PFOC2203/Sistema-de-Controlo-de-Temperatura-utilizando-Celula-de-Peltier/Hardware/PCB.jpeg

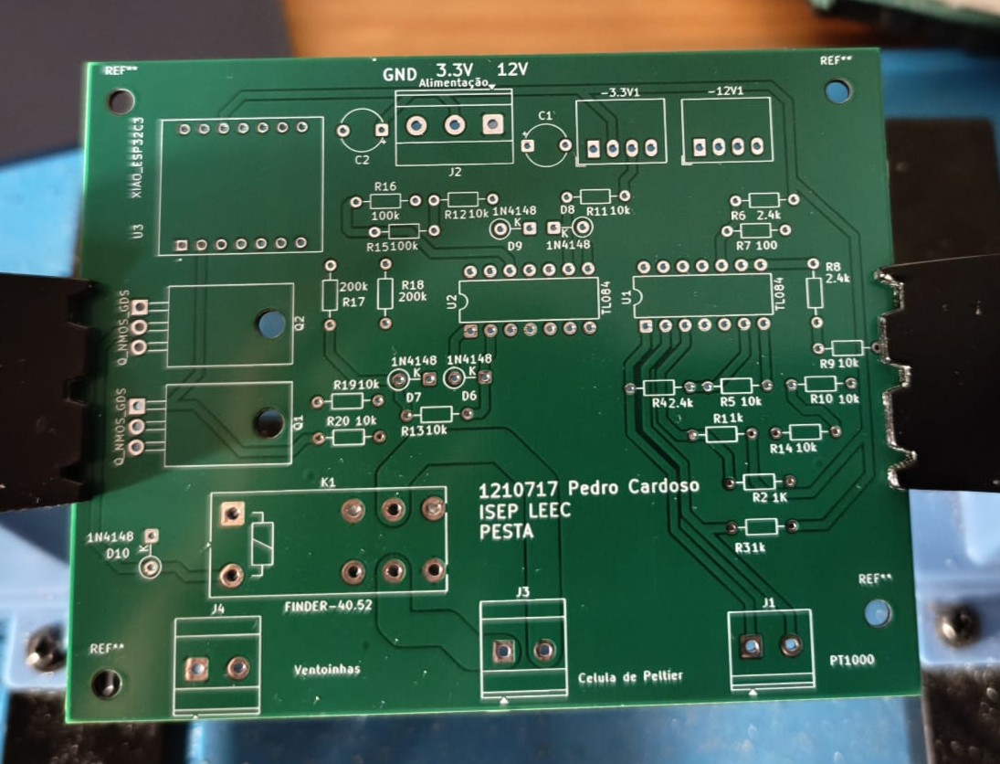
Hardware/PCB.jpeg
