PFOC2203/Sistema-de-Controlo-de-Temperatura-utilizando-Celula-de-Peltier/Hardware/Camera de temperatura regulavel .jpeg

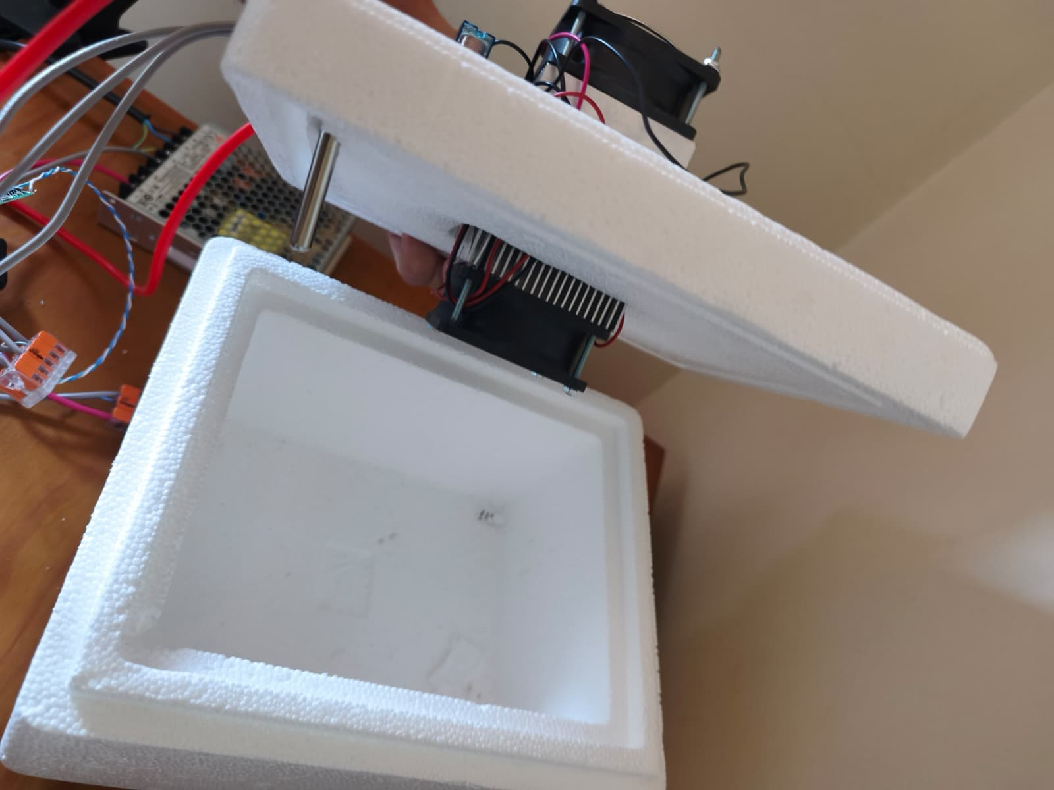
Hardware/Camera de temperatura regulavel .jpeg
