PFOC2203/Sistema-de-Controlo-de-Temperatura-utilizando-Celula-de-Peltier/README.md

# Sistema-de-Controlo-de-Temperatura-utilizando-C-lula-de-Peltier
"Sistema IoT de controlo de temperatura com ESP32C3, Célula de Peltier e interface Web.
