PFOC2203/Sistema-de-Controlo-de-Temperatura-utilizando-Celula-de-Peltier/Relatorio/PESTA_LEEC_RELATORIO v1_1.docx

Sistema de Controlo de Temperatura utilizando Célula de Peltier

Pedro Filipe Oliveira Cardoso

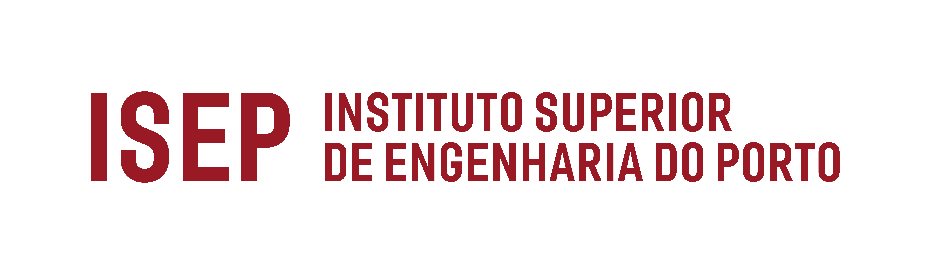
[picture p3: figure]

Departamento de Engenharia Eletrotécnica

Instituto Superior de Engenharia do Porto

2026

Este relatório satisfaz, parcialmente, os requisitos que constam da Ficha de Unidade Curricular de Projeto/Estágio, do 3º ano, da Licenciatura em Engenharia Eletrotécnica e de Computadores

Candidato: Pedro Filipe Oliveira Cardoso, Nº 1210717, 1210717@isep.ipp.pt

Orientador: Ricardo Jorge Guedes da Silva Nunes da Costa, RJC@isep.ipp.pt

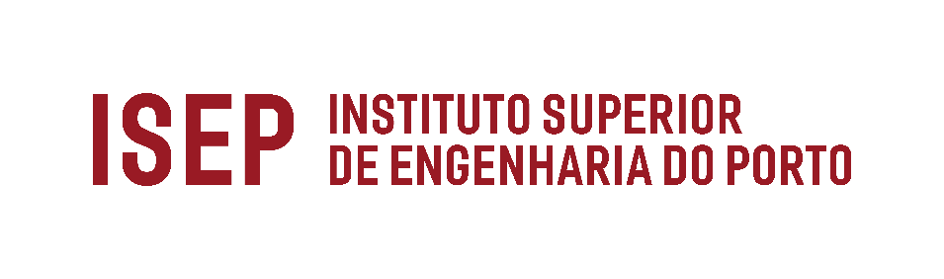
[picture p4: figure]

Departamento de Engenharia Eletrotécnica

Instituto Superior de Engenharia do Porto

10 de julho de 2026

# Agradecimentos

O desenvolvimento deste projeto e a conclusão desta licenciatura representam o culminar de uma jornada de enorme exigência. A realidade de ser trabalhador-estudante impôs o desafio diário de conciliar as responsabilidades profissionais com o rigor académico da Engenharia Eletrotécnica e de Computadores, um percurso de sacrifício e resiliência que não teria sido possível sem uma forte rede de apoio.

Em primeiro lugar, gostaria de expressar o meu mais profundo agradecimento aos meus pais e ao meu irmão. Foram o meu maior pilar, compreendendo as minhas ausências e incentivando-me constantemente a não desistir desta dupla jornada, levando-me sempre a elevar o nível deste projeto.

Ao meu orientador, o Eng.º Ricardo Costa, agradeço todo o apoio técnico, a disponibilidade e os valiosos conselhos prestados durante a realização deste trabalho.

Gostaria também de deixar um agradecimento especial ao meu tio, o Eng.º Jorge Cardoso, por toda a ajuda na discussão e descoberta de novas abordagens e soluções, que foram fundamentais para o desenvolvimento tecnológico do protótipo.

Por fim, agradeço a todos os que, direta ou indiretamente, contribuíram para a concretização deste relatório e para o meu crescimento pessoal, académico e profissional.

# Resumo

O presente trabalho descreve o desenvolvimento de um protótipo funcional de uma marmita térmica inteligente com conectividade IoT, concebida para responder de forma inovadora à problemática da conservação e regeneração alimentar controlada remotamente. O sistema proposto baseia-se numa arquitetura embebida centrada no microcontrolador XIAO ESP32-S3, responsável por gerir a monitorização térmica em tempo real através de um sensor RTD PT1000 de elevada precisão e por atuar sobre o controlo de potência de uma célula de Peltier. No domínio do hardware, concebeu-se e implementou-se uma placa de circuito impresso (PCB) biface otimizada para baixo ruído, integrando uma Ponte de Wheatstone e um circuito delimitador de precisão (Precision Bounding Circuit) com amplificadores operacionais TL084, garantindo o confinamento seguro do sinal analógico na gama analógica de 0 V a 3,3 V. O firmware foi estruturado sob o sistema operativo em tempo real FreeRTOS, recorrendo a mecanismos de exclusão mútua (Mutex) para assegurar a concorrência segura entre as tarefas críticas de aquisição de sinal e a gestão do servidor Web assíncrono embebido. Os ensaios experimentais e a validação laboratorial comprovaram o elevado desempenho dinâmico da malha de controlo digital por histerese, registando uma elevação transiente desde os 35,3 °C até um pico de regeneração de 95,5 °C em aproximadamente 21 minutos, bem como uma estabilização controlada na vizinhança dos 18 °C na fase de arrefecimento. Por fim, a análise económica validou a viabilidade do protótipo com um custo total de investimento de 124,16 €, projetando uma elevada competitividade de mercado num cenário de transição para a produção industrial em série.

Palavras-Chave: Célula de Peltier, IoT, ESP32-S3, PT1000, FreeRTOS, Condicionamento de Sinal.

# Abstract

This work describes the development of a fully functional prototype for an IoT-enabled smart thermal lunchbox, designed to address the engineering challenges of remote food preservation and controlled reheating. The proposed system is built upon an embedded architecture centered on the XIAO ESP32-S3 microcontroller, which manages real-time thermal monitoring via a high-precision PT1000 RTD sensor and controls the power delivery to a thermoelectric Peltier cell. On the hardware layer, a low-noise double-layer printed circuit board (PCB) was developed, integrating a Wheatstone bridge and a precision bounding circuit featuring TL084 operational amplifiers to properly condition the analog signal within the microcontroller’s safe 0 V to 3.3 V ADC range. The firmware architecture was deployed under the FreeRTOS real-time operating system, employing mutual exclusion primitives (Mutex) to guarantee safe resource concurrency between critical signal acquisition tasks and the embedded asynchronous Web server layer. Experimental validation and laboratory trials demonstrated outstanding dynamic performance from the digital hysteresis control loop, achieving a transient temperature rise from 35.3 °C to a peak reheating value of 95.5 °C in approximately 21 minutes, alongside precise stabilization at 18 °C during the food preservation cooling phase. Finally, an economic assessment validated the prototype's financial feasibility with a total component investment of €124.16, projecting high market competitiveness under a mass-production industrial scaling scenario.

Keywords: Peltier Cell, IoT, ESP32-S3, PT1000, FreeRTOS, Signal Conditioning.

# Índice

# Índice de Figuras

# Índice de Tabelas

Acrónimos

ADC Analog-to-Digital Converter (Conversor Analógico-Digital)

BLE Bluetooth Low Energy

COP Coefficient of Performance (Coeficiente de Performance)

DPDT Double Pole Double Throw (Relé de dupla inversão)

FSM Finite State Machine (Máquina de Estados Finitos)

GPIO General Purpose Input/Output

IoT Internet of Things (Internet das Coisas)

NVS Non-Volatile Storage (Armazenamento Não Volátil)

PCB Printed Circuit Board (Placa de Circuito Impresso)

PID Proportional-Integral-Derivative (Controlador Proporcional-Integral-Derivativo)

PWM Pulse Width Modulation (Modulação por Largura de Pulso)

RTD Resistance Temperature Detector (Detetor de Temperatura por Resistência)

TEC Thermoelectric Cooler (Célula Termoelétrica de Peltier)

# 1 Introdução

Neste capítulo, é feita a apresentação do projeto, começando por uma contextualização da problemática do controlo de temperatura e do estado da arte. São também definidos os objetivos principais do trabalho, sendo ainda apresentada a metodologia e a calendarização adotadas para a sua execução.

## Contextualização e Estado da Arte

Nos dias atuais verificamos uma necessidade de manter a nossa comida quente e pronta a comer quando nos encontramos distanciados de instalações de apoio. O produto desenvolvido foi projetado para profissionais que não têm acesso a infraestruturas para aquecer/manter o seu almoço/jantar a uma temperatura própria para consumo. Podemos encontrar no mercado duas gamas de produtos, existem produtos completos e com sistemas IoT, permitindo algumas funcionalidades remotas através de um dispositivo externo, os mesmos proporcionam o controlo da temperatura do espaço. A segunda gama de produtos é constituída por produtos de custo reduzido com uma qualidade inferior, não proporcionando a possibilidade de controlo de temperatura.

Ambas as gamas baseiam-se num sistema de aquecimento por uma resistência elétrica térmica convencional. Caso trabalhem em malha fechada, raramente é com um sensor de temperatura elétrico, mas sim com um termóstato mecânico, eliminando assim a precisão e controlo da temperatura interna da marmita. Com o projeto desenvolvido é possível controlar com precisão a temperatura da marmita devido ao sistema de alta precisão de leitura de temperatura, com um sensor de platina e um microcontrolador, que nos proporciona um controlo rápido e eficaz do atuador, uma pastilha termoelétrica. O microcontrolador proporciona uma vantagem de muito valor, a capacidade de acedermos à distância e controlarmos o sistema. A pastilha termoelétrica proporciona um funcionamento eficiente.

O projeto insere-se numa gama intermediária, pretendemos oferecer a qualidade, o controlo e a interligação da gama superior, mantendo o preço da gama mais acessível, aproveitando assim uma lacuna no mercado.

## Objetivos

O projeto nasce de uma necessidade de preencher as ineficiências identificadas nas soluções atuais, oferecendo uma solução equiparável a equipamentos de gama alta para todo o público. Neste sentido, o trabalho desenvolve-se em torno de um objetivo macro e de metas operacionais bem definidas.

### Objetivo Geral

Desenvolver e implementar um sistema portátil de controlo térmico de uma câmara térmica, através de uma célula de Peltier, que substitua os tradicionais e ineficientes termóstatos mecânicos por um sistema de controlo digital. Simultaneamente, pretende-se integrar o sistema no paradigma de IoT, utilizando um microcontrolador ESP32 para dotar o equipamento de conectividade sem fios e telemetria remota.

#### Objetivos Específicos

Para assegurar o cumprimento do objetivo geral e atestar o rigor técnico da solução, estabelecem-se os seguintes objetivos específicos:

- Aquisição e Condicionamento de Precisão: Projetar e implementar um circuito de condicionamento analógico para o sensor PT1000, recorrendo a uma topologia de superdíodo (retificador de precisão). Esta abordagem visa anular a não-linearidade e a deriva térmica das junções semicondutoras normais, garantindo a máxima fidelidade do sinal entregue ao conversor analógico-digital (ADC).
- Implementação de Controlo Digital em Malha Fechada: Desenvolver um algoritmo de controlo ON/OFF com banda de histerese dinâmica definida por software, superando a inércia e a imprevisibilidade dos termóstatos mecânicos bimetálicos comerciais, por forma a assegurar a estabilidade térmica na faixa de segurança alimentar.
- Gestão Multitarefa e Integração IoT: Programar o microcontrolador ESP32 com recurso ao FreeRTOS para isolar e priorizar a rotina de controlo térmico face às operações de rede. Simultaneamente, implementar um Servidor Web embebido para configuração remota do setpoint e monitorização da telemetria.
- Validação Estatística e Experimental: Efetuar a caracterização térmica do protótipo em funcionamento. Esta análise estatística visa quantificar o desvio de pior cenário (worst-case senário) induzido pelas tolerâncias dos componentes passivos, fundamentando as escolhas do projeto de hardware.

## Metodologia de Desenvolvimento

O desenvolvimento deste projeto afastou-se do modelo linear tradicional, adotando uma Metodologia Empírica de Prototipagem Iterativa. Esta abordagem foi escolhida devido à elevada não-linearidade térmica das células de Peltier e às restrições de espaço físico impostas pela natureza portátil do protótipo. O ciclo de desenvolvimento foi estruturado em quatro fases incrementais:

- Exploração e Dimensionamento Espacial: A seleção dos elementos de dissipação térmica foi primordialmente condicionada pelas restrições volumétricas da própria câmara, preterindo-se, nesta fase inicial, um dimensionamento térmico puramente analítico a priori. Em contraste, o dimensionamento e a seleção de todos os componentes elétricos e eletrónicos do sistema foram realizados de forma rigorosa, obedecendo a critérios matemáticos e metodologias técnicas exatas.
- Prototipagem de Hardware e Validação Qualitativa: Montagem do circuito de potência e execução de ensaios de prova de conceito (Proof of Concept). A capacidade de dissipação térmica foi confirmada de forma empírica e qualitativa, verificando a efetiva transferência de calor e a capacidade de arrefecimento do dissipador no interior do espaço confinado.
- Desenvolvimento Iterativo de Firmware: Programação do microcontrolador ESP32 através de abordagens sucessivas. Iniciou-se com a validação da atuação (On/Off), evoluindo para a implementação de técnicas de mitigação de fadiga térmica em software e culminando na sintonização de um controlo digital PID suportado por um ambiente de tempo real (FreeRTOS).
- Integração IoT e Validação de Desempenho: Acoplamento da interface de rede (Servidor Web assíncrono) ao sistema de controlo crítico. A validação final de desempenho baseou-se na extração de telemetria serial do sensor de temperatura, comprovando o rigor da estabilização térmica face ao estado da arte.

## Calendarização

A execução do projeto decorreu ao longo de dois períodos letivos distintos. Esta distribuição temporal permitiu uma fase de maturação teórica e exploração de hardware, seguida de uma fase intensiva de desenvolvimento prático, correção de requisitos e programação avançada. O cronograma reflete as seguintes macro atividades:

Fase 1: Conceção, Estudo e Aquisição (Ano Letivo 2024/2025)

- Pesquisa e Levantamento de Soluções: Revisão de literatura técnica sobre refrigeração termoelétrica, componentes semicondutores e topologias de controlo comercialmente disponíveis.
- Aquisição de Material e Restrições Geométricas: Seleção e compra dos componentes base essenciais (célula de Peltier, unidade de processamento ESP32, sensor de temperatura Termo resistivo PT1000). A escolha dos dissipadores térmicos obedeceu prioritariamente a critérios de adequação física ao formato da célula e volume da câmara portátil.
- Provas de Conceito Preliminares: Ensaios básicos de laboratório para verificar a operacionalidade da célula de Peltier e o comportamento térmico dos dissipadores antes da integração final.

Fase 2: Desenvolvimento de Hardware, Firmware e Validação (Ano Letivo 2025/2026)

- Validação de Circuitos e Eletrónica de Potência: Projeto e montagem em bancada do circuito de condicionamento de sinal para o sensor PT1000 e da etapa de potência (transístores MOSFET e relés) responsável por suportar as correntes elevadas e garantir a segurança elétrica do sistema.
- Desenvolvimento de Firmware e IoT: Implementação do algoritmo de controlo digital (PID) e criação do Servidor Web para monitorização remota. Desenvolvimento de rotinas em software para mitigar as limitações de hardware face a transientes na célula Peltier.
- Testes de Validação Experimental: Ensaios finais utilizando a câmara física fechada, recorrendo ao feedback do sensor PT1000 interno para comprovar a capacidade de arrefecimento real e a estabilidade do sistema.
- Análise de Resultados e Redação: Estruturação dos dados empíricos extraídos do microcontrolador, documentação técnica e elaboração da dissertação final.

# 2 Arquitetura geral do Sistema

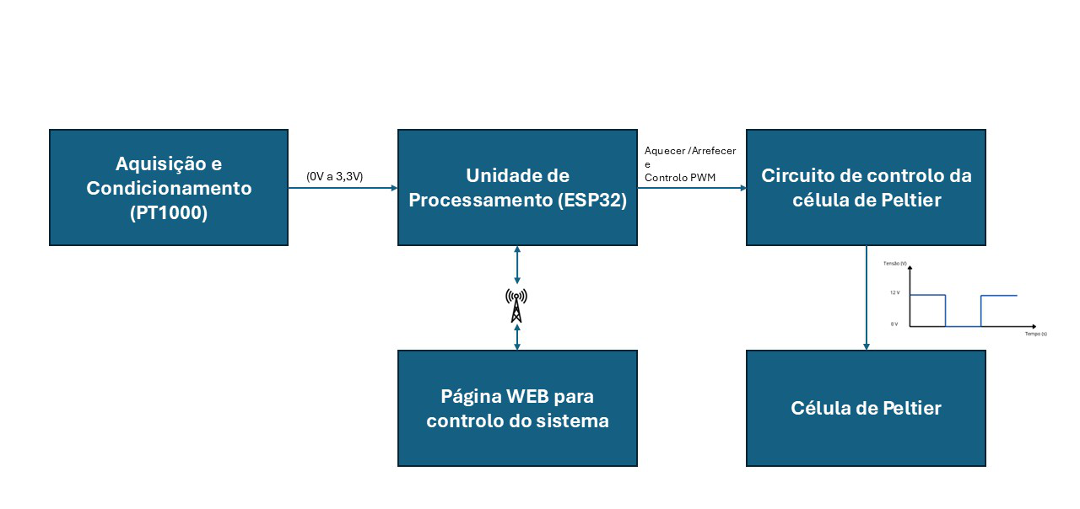
[picture p5: figure]

## Diagrama de Blocos e Funcionamento Global

Figura 1Diagrama de Blocos

A arquitetura do sistema desenvolvido foi estruturada de forma modular, separando fisicamente e logicamente as etapas de aquisição de dados, processamento central, atuação de potência e interface de utilizador. O funcionamento global do protótipo baseia-se num sistema de controlo em malha fechada (closed-loop), cujo fluxo de informação pode ser analisado através do diagrama de blocos (Figura 1).

O ciclo de operação inicia-se no bloco de Aquisição e Condicionamento de Sinal. O sensor Termo resistivo, localizado no interior do compartimento térmico, regista a temperatura ambiente. Como a unidade de processamento não interpreta variações de resistência, o sinal passa por um circuito de condicionamento analógico que o converte numa tensão proporcional, compreendida no intervalo de operação seguro do Conversor Analógico-Digital (ADC) do microcontrolador (0 V a 3,3 V).

A informação digitalizada é então entregue à Unidade de Processamento. Este componente atua como o "cérebro" do sistema, executando três tarefas fundamentais suportadas pelo seu sistema operativo de tempo real (FreeRTOS):

- Conversão da Tensão lida para uma variável de temperatura.
- Em conformidade com o valor da temperatura, define as condições para o funcionamento da pastilha termoelétrica.
- Gere as comunicações de rede (Wi-Fi), garantindo a atualização bidirecional de dados com a Página Web de monitorização.

Após o processamento digital, o ESP32 gera os sinais de comando direcionados ao Circuito de Controlo de Potência. Esta etapa de atuação recebe dois sinais distintos: um sinal lógico (Digital de Nível) que dita o sentido da corrente (modo de aquecimento ou arrefecimento) e um sinal On/Off que define o funcionamento ou não funcionamento da célula de peltier.

Por fim, a eletrónica de potência amplifica estes sinais para tensões e correntes elevadas (tipicamente 12 V), acionando a Célula. Esta converte a energia elétrica num diferencial térmico, ajustando a temperatura do compartimento isolado e fechando, assim, o ciclo de feedback do sistema.

## Monitorização da Temperatura

A etapa de aquisição de dados é responsável pela transdução contínua da variável de processo térmica num sinal digital quantizado, estabelecendo o ramo de realimentação (feedback) necessário para a operação em malha fechada.

O elemento primário de captação é um termómetro de resistência de platina (RTD). Este sensor passivo de coeficiente de temperatura positivo (PTC) foi selecionado pela sua elevada linearidade e estabilidade a longo prazo. A sua operação baseia-se na variação previsível da resistência elétrica da platina em função da temperatura ambiente.

Sendo a unidade de processamento um dispositivo assente em níveis lógicos de tensão, a integração do sensor Termo resistivo exige uma etapa intermédia de condicionamento de sinal analógico. A arquitetura deste bloco tem como função realizar a conversão de impedância e escalar a amplitude do sinal, mapeando a variação resistiva de interesse para uma janela de tensão estritamente contida entre valores estipulados.

O sinal condicionado é posteriormente injetado no periférico de conversão analógico-digital (ADC) do microcontrolador. O ADC efetua a amostragem e a quantização do sinal analógico, transformando o nível de tensão contínuo numa representação digital discreta. Esta abstração numérica passa a constituir a Variável de Processo (PV — Process Variable) no algoritmo de controlo, refletindo o estado térmico do recinto em tempo real com resolução ditada pelas características de amostragem do microcontrolador.

## Controlo da Temperatura

Para garantir a estabilidade do sistema e adequar o esforço de controlo à elevada inércia térmica da câmara, a arquitetura processual integra um controlador lógico discreto (ON/OFF) com uma banda de histerese programada por software. Este algoritmo avalia o estado atual e determina o estado de atuação de forma digital, superando a imprevisibilidade e as oscilações típicas dos termóstatos mecânicos convencionais.

Para que a decisão computacional transite para o domínio da potência física, a unidade de processamento atua sobre a eletrónica de comutação da célula termoelétrica (TEC — Thermoelectric Cooler) através de uma grandeza de saída singular:

- Comutação Digital de Potência: Um sinal lógico de nível discreto responsável por acionar o estágio de potência (por exemplo, via transístor MOSFET ou relé eletromecânico). Esta abordagem direta garante ciclos de comutação longos, substituindo técnicas de modulação de alta frequência (como o PWM). Desta forma, protege-se a integridade estrutural das junções semicondutoras da pastilha de Peltier contra a fadiga termomecânica e previne-se a degradação da eficiência por Efeito de Joule associada à ausência de filtros LC. O fluxo de transferência de calor é assim gerido em perfeita sintonia com a elevada constante de tempo do sistema físico.

# 3 Analise e escolha da tecnologia adotada

## Sensores de Temperatura

Globalmente, existem inúmeras soluções de medição de temperatura implementadas no mercado, destacando-se os termístores (NTC/PTC), os termopares e os detetores de temperatura por resistência (RTDs). O objetivo do projeto em questão é monitorizar valores dentro de um intervalo térmico específico, compreendido entre os -20 °C e os 100 °C.

Para garantir a escolha da tecnologia mais adequada a esta exigência, será feita de seguida uma análise detalhada ao comportamento, vantagens e desvantagens de cada um destes sensores.

### Termístores (NTC/PTC)

Um termístor é um sensor resistivo que atua como um resistor dependente da temperatura, fabricado essencialmente a partir de materiais semicondutores (como óxidos cerâmicos). O princípio de funcionamento destes sensores baseia-se na alteração do comportamento dos materiais semicondutores quando aquecem. O calor fornece energia aos eletrões, permitindo-lhes saltar para a banda de condução (ultrapassando a lacuna de energia), o que facilita o fluxo da eletricidade. Consequentemente, isto implica uma variação da resistência aos terminais do componente em conformidade com a temperatura exterior. [1]

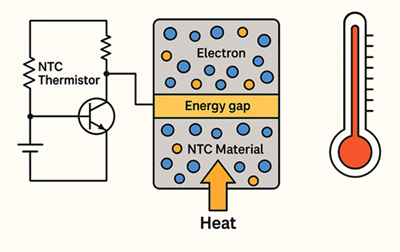
[picture p6: figure]
NTC Thermistor Works

Figura 2 Constituição Termístores

Existem dois tipos principais de termístores, que apresentam comportamentos elétricos completamente opostos: no termístor NTC, a resistência elétrica do sensor diminui (sendo inversamente proporcional) à medida que a temperatura aumenta. Pelo contrário, no termístor PTC, a resistência aumenta abrupta e significativamente quando a temperatura sobe. Pode visualizar na Figura X as diferentes curvas de comportamento deste tipo de sensores.

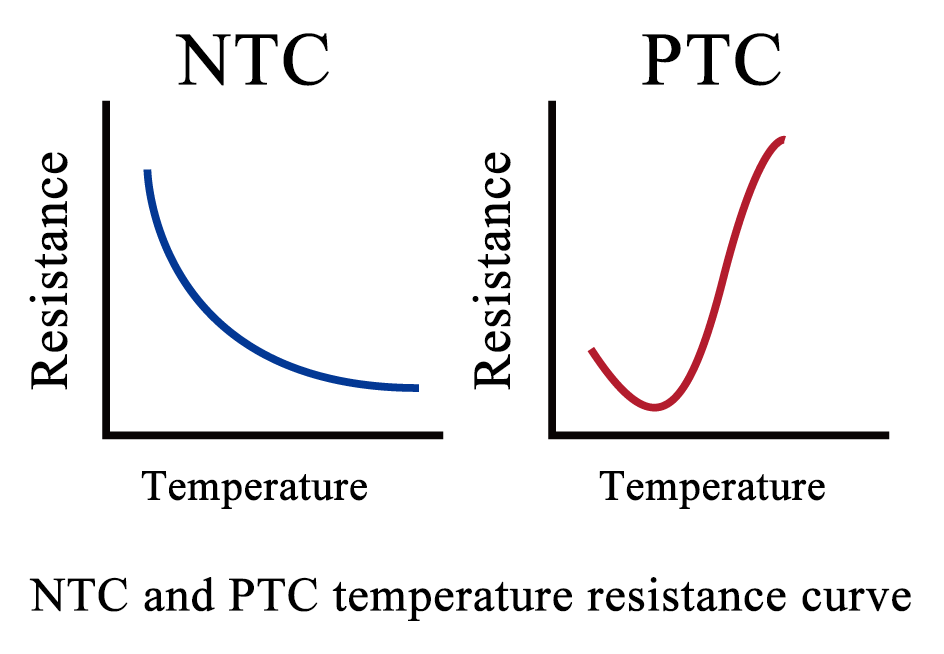
[picture p7: figure]

Figura 3 Curvas de resistência-temperatura dos termistores NTC e PTC [2]

Como demonstrado no gráfico, na curva NTC a resistência sofre uma forte queda (rápida e não linear) à medida que a temperatura aumenta. Por sua vez, na curva PTC, o comportamento inverte-se, com a resistência a aumentar significativamente à medida que a temperatura sobe.

#### Vantagens

- Alta sensibilidade: A sua mudança acentuada de resistência fornece uma excelente resolução para a monitorização em tempo real.
- Tamanho compacto: Estes componentes possuem pacotes pequenos que cabem facilmente em dispositivos wearables, sondas médicas, módulos de bateria e dispositivos de consumo.
- Resposta rápida: As variantes de contas e vidro conseguem acompanhar mudanças rápidas de temperatura de forma ágil.
- Integração com eletrónica simples: Normalmente, a utilização de um divisor básico e de um ADC é suficiente para fornecer resultados precisos, sem exigir condicionamento especializado do sinal.
- Ampla disponibilidade: Existem em diversas versões (encapsuladas em grânulo, chip, disco, SMD e vidro), o que lhes permite cobrir uma ampla variedade de ambientes de aplicação.

#### Desvantagens

- Curva não linear: Como não possuem um comportamento linear, exigem o uso de equações matemáticas ou tabelas de pesquisa (lookup tables) para converter a resistência em leituras de temperatura precisas.
- Faixa de temperatura mais estreita: Os termístores NTC não conseguem igualar a capacidade dos termopares em temperaturas extremas, nem a linearidade de longo alcance dos sensores RTD.
- Auto-aquecimento: A corrente que flui através do sensor produz calor próprio, o que pode distorcer as leituras se a corrente de deteção for excessiva e não for devidamente controlada ou compensada.
- Sensibilidade ambiental e envelhecimento: A deriva a longo prazo varia consoante os materiais e o encapsulamento do sensor. Além disso, fatores como a humidade ou produtos químicos podem afetar negativamente as embalagens que não estejam perfeitamente seladas.

### Termopares

Um termopar é um dispositivo de medição de temperatura que assenta o seu funcionamento no princípio do efeito Seebeck, descoberto no ano de 1821 por Thomas Johann Seebeck. Na sua construção mais básica, este sensor consiste em dois fios de metais diferentes unidos numa das suas extremidades, ponto a que se dá o nome de junção de medição ou junção quente. A outra extremidade dos fios, conhecida como junção de referência ou junção fria, é mantida a uma temperatura conhecida e constante.

O princípio de funcionamento de um termopar baseia-se na geração de uma tensão elétrica (força eletromotriz) num circuito fechado composto por dois metais distintos, sempre que ocorre uma diferença de temperatura entre a junção quente e a junção fria.

Essa diferença de temperatura gera uma tensão específica — tipicamente medida em milivolts (mV) — devido ao efeito Seebeck. A magnitude deste sinal elétrico é diretamente proporcional à diferença térmica entre as duas junções e a sua sensibilidade é definida pelo Coeficiente Seebeck, que varia consoante a combinação de metais escolhida para os fios.

Como a relação entre a temperatura e a tensão gerada não é perfeitamente linear na maioria dos termopares, a leitura não é direta. A tensão medida (através de um voltímetro ou microcontrolador) precisa de ser convertida no valor correto de temperatura utilizando tabelas de calibração ou equações matemáticas específicas para o tipo de termopar utilizado. [3]

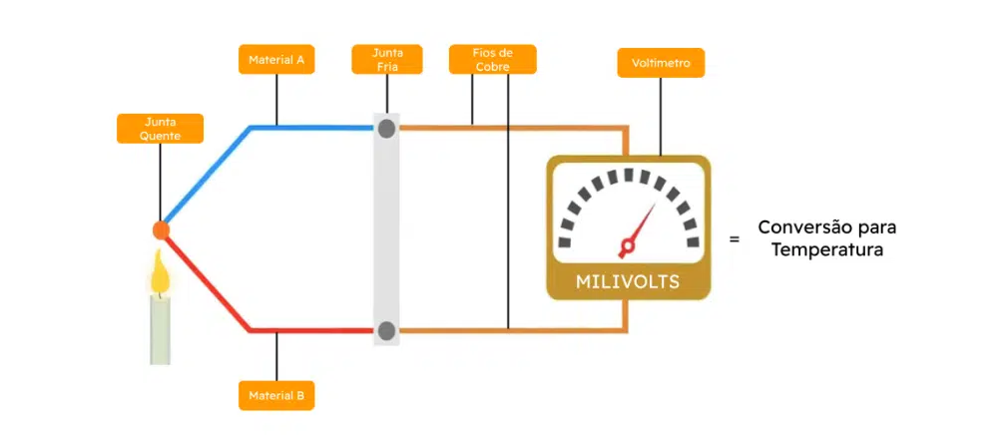
[picture p8: figure]

Figura 4 Esquema do Princípio de Funcionamento[3]

#### Vantagens

Devido à sua simplicidade e robustez, os termopares oferecem benefícios notáveis para aplicações industriais e de pesquisa:

- Ampla faixa de medição: São capazes de medir desde temperaturas criogénicas, como -200°C, até calor extremo superior a 2300°C, dependendo exclusivamente dos materiais que os compõem.
- Resposta rápida: Graças à sua construção simples e elementos sensores diretos, reagem de forma bastante célere às mudanças de temperatura no ambiente.
- Elevada durabilidade e resistência: São componentes muito robustos que podem ser utilizados sob condições extremas, suportando ambientes severos, altas pressões e até atmosferas corrosivas.
- Integração facilitada: Possuem uma impedância de saída geralmente muito baixa, o que significa que podem ser ligados a dispositivos de leitura de alta impedância de entrada sem que isso resulte numa perda significativa de precisão.

#### Desvantagens

Apesar da sua robustez, o uso de termopares exige que certas limitações e características elétricas sejam devidamente geridas no circuito:

- Comportamento não linear: A resposta entre temperatura e tensão gerada não é linear, o que obriga à implementação de tabelas de conversão ou algoritmos de correção no sistema de leitura.
- Sinal elétrico fraco: A tensão produzida é muito baixa (medida em milivolts), o que torna o sistema suscetível a ruído elétrico e a interferências externas que podem comprometer a precisão.
- Necessidade de compensação: O cálculo da temperatura exige obrigatoriamente que se conheça a temperatura da junção fria, o que obriga a que os sistemas modernos incluam uma etapa eletrónica extra para medir e compensar a temperatura dessa junção.
- Resistência elétrica dos fios: Em casos onde os cabos são muito longos, a própria resistência elétrica dos fios do termopar pode afetar o sinal e introduzir erros indesejados nas medições.
- Deriva a longo prazo (Drift): Com o passar do tempo, o sensor pode apresentar uma mudança gradual na leitura devido a alterações químicas ou físicas nos seus materiais, como fenómenos de contaminação ou oxidação.
- Restrições por tipo de material: Certos tipos de termopares apresentam fragilidades específicas do seu material. Por exemplo, o Tipo J é bastante propenso à oxidação, enquanto os Tipos B, R e S (feitos de Platina e Ródio) acarretam custos financeiros muito mais elevados.

### RTD

Um RTD (Resistance Temperature Detector - Detetor de Temperatura por Resistência), também conhecido como Termo resistência, é um sensor cuja resistência elétrica sofre alterações em função da temperatura a que está exposto. Ao contrário dos termístores NTC, num RTD a resistência aumenta à medida que a temperatura do sensor sobe. A relação entre a resistência e a temperatura nestes componentes é bem conhecida, previsível e altamente repetível ao longo do tempo.

O RTD é um dispositivo passivo, o que significa que não gera nenhum sinal elétrico por conta própria. Para que funcione, é necessário o uso de dispositivos eletrónicos externos que façam passar uma pequena corrente elétrica através do sensor, gerando assim uma tensão mensurável. Esta corrente de medição é habitualmente de 1 mA ou inferior, não devendo ultrapassar um limite máximo de 5 mA para evitar o risco de autoaquecimento do componente, o que prejudicaria a precisão da leitura. Na prática, a medição da temperatura com um RTD envolve medir a sua resistência de forma muito rigorosa, sendo a ponte de Wheatstone desequilibrada o método de circuito mais utilizado para este fim. O elemento mais padronizado e comum na indústria é o RTD de Platina, que apresenta uma resistência base de 100 ohms a 0 °C (curva padronizada DIN) e um coeficiente de temperatura de 0,00385 ohm/ohm/°C. Para além da platina, os elementos também podem ser fabricados em níquel ou cobre, cada um com as suas resistências base e coeficientes de temperatura específicos. A precisão do sensor depende de classes de tolerância padronizadas (DIN Classe A, B ou C). A temperatura de calibração mais comum é 0 °C, e qualquer medição que se afaste substancialmente deste valor apresentará uma faixa de tolerância mais ampla, ou seja, menor precisão.[4]

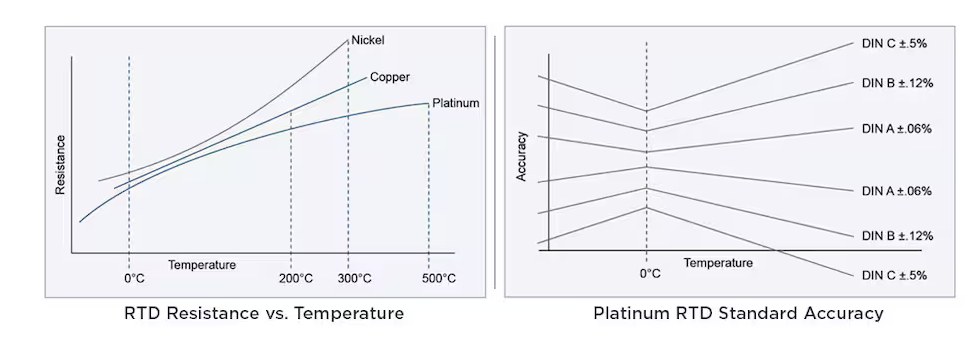
[picture p9: figure]

Figura 5 Curvas de preisão e caracterização do Sensor [4]

#### Vantagens

A tecnologia RTD oferece vantagens técnicas assinaláveis, nomeadamente em aplicações que exigem fiabilidade:

- Elevada repetibilidade: A relação direta entre a resistência e a temperatura mantém-se consistente e pode ser repetida de forma fiável ao longo do tempo.
- Padronização global: A resposta do sensor obedece a curvas e tolerâncias estritamente padronizadas (como a norma DIN), o que facilita o seu intercâmbio e previsibilidade no design de circuitos.
- Capacidade de compensação de erros: Ao utilizar configurações de três fios, é possível integrar um circuito de medição que subtrai a resistência indesejada dos cabos, oferecendo uma excelente combinação de precisão e conveniência técnica.
- Máxima precisão com 4 fios: A montagem do sensor em configurações de quatro fios permite efetuar uma leitura pura da resistência do sensor, eliminando por completo qualquer influência (e erro) provocada pelos fios condutores de ligação.

#### Desvantagens

A implementação de RTDs exige a compensação de alguns desafios intrínsecos ao seu funcionamento elétrico:

- Necessidade de alimentação externa: Como são dispositivos passivos, requerem hardware adicional (fonte de corrente controlada) para gerar um sinal elétrico que possa ser lido pelo sistema.
- Risco de autoaquecimento: Se a corrente elétrica utilizada para a medição for superior a 5 mA, a resistência interna do sensor vai gerar calor próprio, introduzindo falsas variações na temperatura medida.
- Erros na configuração simples (2 fios): Em ligações de dois fios, a medição é tecnicamente simples, mas inerentemente imprecisa, pois não há forma de o circuito isolar a resistência do elemento sensor da resistência somada dos próprios fios de ligação.
- Restrições de hardware na configuração ideal (4 fios): Embora a configuração de quatro fios seja a que oferece a melhor precisão, muitos controladores industriais e dispositivos de medição padrão não têm a capacidade técnica de realizar uma verdadeira leitura de quatro fios.

### Escolha do Sensor

O sensor que melhor se enquadra nas exigências deste projeto é o RTD, devido à sua elevada precisão e excelente linearidade. Sendo um dos principais objetivos do projeto oferecer um produto de alta qualidade, é fundamental garantir um feedback de temperatura estritamente rigoroso e fiável. Deste modo, o RTD destaca-se das restantes opções por proporcionar a maior exatidão e estabilidade na medição.

A exclusão do termopar como solução justificou-se por vários motivos técnicos. Embora seja um sensor robusto, a sua tensão de saída é extremamente baixa e suscetível a ruídos elétricos, o que exigiria um circuito complexo de amplificação e a obrigatoriedade de compensação da junção fria. Além disso, o termopar apresenta uma menor precisão e sensibilidade nesta gama de temperaturas face ao RTD. Por outro lado, a exclusão dos termístores fica implícita pela sua forte não linearidade, que exigiria um processamento de sinal (e calibração) muito mais complexo para garantir o mesmo nível de rigor.

Como foi analisado anteriormente, uma das principais desvantagens do RTD é a necessidade de uma fonte de alimentação externa para a sua excitação. Contudo, como o sistema já dispõe de uma fonte integrada, esta limitação é facilmente contornada, consolidando o RTD como a solução ideal.

De notar que, para a gama de temperaturas definida para a leitura (entre os -20 °C e os 100 °C), todas as opções estudadas seriam perfeitamente compatíveis. Por conseguinte, a amplitude térmica não foi o fator de exclusão, recaindo a decisão final inteiramente na fiabilidade, simplicidade de integração e linearidade garantidas pelo RTD.

## Microcontrolador e Conectividade (IoT)

### Unidade de Processamento e Conectividade (IoT)

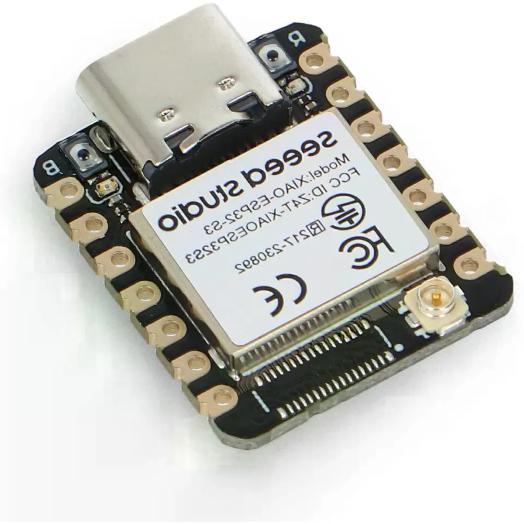
[picture p10: figure]

Figura 6 Microcontrolador Seeed Studio XIAO ESP32-S3

Na fase inicial de conceção do projeto, equacionou-se a utilização de um microcontrolador de 8 bits (como o Arduino Nano). Contudo, o requisito rigoroso por uma solução de dimensões ultracompactas, aliado à necessidade de um poder de processamento superior para a gestão de dados, ditou a exclusão dessa arquitetura. A escolha tecnológica recaiu sobre a placa de desenvolvimento Seeed Studio XIAO ESP32-S3, amplamente reconhecida pela sua versatilidade, elevado desempenho e pegada física reduzida.

Os principais argumentos técnicos que justificam esta adoção no projeto são:

- Compacidade e Flexibilidade de Hardware: O fator dimensão foi uma premissa determinante na arquitetura do sistema. O módulo da Seeed Studio apresenta dimensões altamente reduzidas, ideais para projetos IoT sujeitos a restrições de espaço. Adicionalmente, oferece a conveniência de alimentação via conector USB-C ou através de bateria, incluindo uma antena removível (U.FL) para otimização do alcance do sinal de rádio.
- Poder Computacional e Gestão Multitarefa: O núcleo desta placa baseia-se num microprocessador Xtensa® dual-core de 32 bits (LX7), capaz de operar a uma frequência máxima de 240 MHz. Esta arquitetura oferece a capacidade de processamento necessária para executar rapidamente rotinas de controlo e de processamento de dados de forma paralela.
- Conectividade IoT Nativa: O microcontrolador suporta nativamente conectividade Wi-Fi (IEEE 802.11 b/g/n) e Bluetooth® Low Energy (BLE). Esta integração no próprio silício elimina a necessidade de acoplar módulos de rede externos e estabelece a infraestrutura essencial para a comunicação IoT do produto.
- Memória Alargada: A placa XIAO ESP32-S3 integra 8 MB de memória PSRAM e 8 MB de memória Flash. Estas especificações garantem amplos recursos de armazenamento para acomodar algoritmos complexos, interfaces web e rotinas de comunicação de rede.
- Interfaces e Flexibilidade de Software: O módulo disponibiliza 11 pinos GPIO multifuncionais e suporta nativamente as principais interfaces de comunicação digital, tais como UART, I2C, I2S e SPI. Adicionalmente, garante uma enorme flexibilidade ao nível do desenvolvimento de software, sendo plenamente compatível com o Arduino IDE, ESP-IDF, CircuitPython e MicroPython.
- Condicionamento Analógico-Digital e Segurança: A arquitetura do chip ESP32-S3 integra conversores analógico-digitais (ADC) com 12 bits de resolução, garantindo a granularidade necessária para a aquisição digital precisa de sinais analógicos. Integra também módulos dedicados de segurança por hardware (tais como AES, SHA e Secure Boot), conferindo proteção e integridade à aplicação de rede.
- Gestão de Energia: O dispositivo possui uma unidade de gestão de energia otimizada para operações IoT eficientes, disponibilizando múltiplos modos de baixo consumo, nomeadamente Modem-sleep, Light-sleep e Deep-sleep.

Em suma, a adoção da Seeed Studio XIAO ESP32-S3 responde de forma exímia ao compromisso exigido entre um formato físico ultrarreduzido e um elevado poder de processamento, assegurando simultaneamente o cumprimento de todos os requisitos de conectividade necessários para a aplicação IoT. [5]

## Atuadores Térmicos

Neste projeto, a seleção do atuador térmico exigiu uma análise comparativa entre duas tecnologias distintas: aquecedores resistivos cerâmicos (PTC) e células termoelétricas de Peltier (TEC). A escolha recaiu sobre a utilização de um módulo Peltier, especificamente o modelo TEC1-12707.

A principal justificação para esta adoção prende-se com a superioridade térmica e energética da célula de Peltier quando operada no modo de aquecimento. Os aquecedores PTC convencionais baseiam-se estritamente no Efeito de Joule, onde a corrente elétrica que atravessa a resistência é convertida em energia térmica. Devido às leis da termodinâmica, este processo possui um Coeficiente de Performance (COP) máximo teórico de 1, o que significa que, por cada Watt de potência elétrica consumida, é gerado, no limite, apenas 1 Watt de calor.

Em contraste, uma célula de Peltier opera como uma bomba de calor em estado sólido. Quando uma corrente contínua atravessa os seus elementos semicondutores, ocorre a absorção de energia térmica numa das faces (face fria) e a correspondente libertação na face oposta (face quente). No modo de aquecimento, o calor total entregue ao sistema pela face quente não se limita apenas à potência elétrica dissipada no interior do componente, a energia entregue é a soma da potência elétrica consumida com a energia térmica que a célula ativamente "bombeou" do ambiente através da sua face fria. Por este motivo, o COP de aquecimento de uma célula de Peltier é invariavelmente superior a 1 (COP > 1), garantindo uma eficiência energética que uma resistência PTC é incapaz de igualar.

O modelo selecionado (TEC1-12707) suporta uma tensão máxima de 15,4 V e uma corrente de operação nominal que se adequa aos requisitos de potência do sistema, oferecendo uma capacidade de transferência de calor de aproximadamente 76 W a uma temperatura base de 25 °C. Para além de garantir um aquecimento altamente eficiente, o módulo permite que o sistema realize arrefecimento ativo através da simples inversão da polaridade da tensão de alimentação, conferindo uma flexibilidade de controlo térmico bidirecional impossível de alcançar com sistemas resistivos puramente passivos.

### Topologias de Controlo e Comutação de Potência

A escolha da topologia de controlo foi balizada por três critérios fundamentais: precisão da temperatura, longevidade do atuador (célula de Peltier) e viabilidade da implementação do hardware de potência.

Foram analisadas três abordagens distintas para a regulação térmica do recinto:

- Termóstatos Bimetálicos: Embora representem a solução comercial de menor custo, foram prontamente descartados devido à sua natureza puramente mecânica e imprevisível. A sua elevada histerese e falta de calibração impedem um controlo térmico rigoroso, resultando em grandes oscilações da temperatura interna, o que compromete a conservação de cargas sensíveis.
- Modulação de Largura de Pulso (PWM): Numa fase de desenho inicial, equacionou-se a utilização de PWM de alta frequência para permitir uma modulação contínua da potência entregue à célula de Peltier. Contudo, esta abordagem revelou-se tecnicamente desaconselhável. Dada a elevada inércia térmica inerente ao sistema (constante de tempo longa do conjunto câmara-atuador), a modulação de alta frequência é redundante. Adicionalmente, a comutação rápida submete a célula a variações de regime que, apesar da suavidade pretendida na potência média, aceleram a fadiga termomecânica das junções semicondutoras devido ao ciclo de stress térmico intra-ciclo, reduzindo desnecessariamente a vida útil do componente.
- Comutação Digital Lenta (ON/OFF com Histerese em Software): Esta foi a topologia adotada. A decisão baseia-se na elevada inércia térmica inerente ao sistema (constante de tempo longa do conjunto câmara-atuador). Dado que o processo térmico é intrinsecamente lento, a comutação de alta frequência revela-se desnecessária. O controlo digital em malha fechada, com histerese programável por software, permite gerir a temperatura de forma eficaz, mantendo a célula num estado de operação estável e seguro, sem o stress térmico induzido pelo PWM.

Quanto ao estágio de potência, optou-se por realizar um circuito customizado em vez de recorrer a módulos genéricos. Esta opção foi tomada por dois motivos técnicos cruciais:

- Gestão de Correntes Elevadas: O dimensionamento dos componentes de potência (MOSFETs de baixa resistência on-state) foi realizado para assegurar que a corrente de pico (na ordem dos 7 A) é gerida com perdas térmicas mínimas, garantindo a robustez do sistema face a regimes de carga contínua.
- Liberdade de Projeto e Integração: A conceção de um circuito de potência próprio confere liberdade absoluta na escolha dos componentes, permitindo uma integração otimizada com a lógica de controlo do ESP32 e a inclusão de medidas de proteção que módulos comerciais de uso geral frequentemente negligenciam.

# 4 Aquisição de sinal e condicionamento

O sensor RTD escolhido é um PT1000, ou seja, um sensor resistivo de platina cuja resistência aumenta de forma previsível e quase linear com o aumento da temperatura, apresentando uma resistência nominal de 1000 Ω a 0 ºC.

A resistência do sensor PT1000 pode ser calculada através da equação de Callendar-Van Dusen:

[6]

Para o intervalo de −200 °C a 0 °C:

R_t = R_o × [ 1+ A×t+B×t^2 + C×( t-100)t^3

Para o intervalo de 0 °C a 850 °C:

R_t = R_o × ( 1+ A×t+B×t^2 )

Onde:

- R_t é a resistência à temperatura t (em ºC);
- R_0 é a resistência quando t=0 °C (1000 Ω);
- As constantes de calibração nestas equações são:
  - A=3,9083×10^(-3) ^(∘) C^(-1)
  - B=-5,775×10^(-7) ^(∘) C^(-2)
  - C=-4,183×10^(-12) ^(∘) C^(-4)

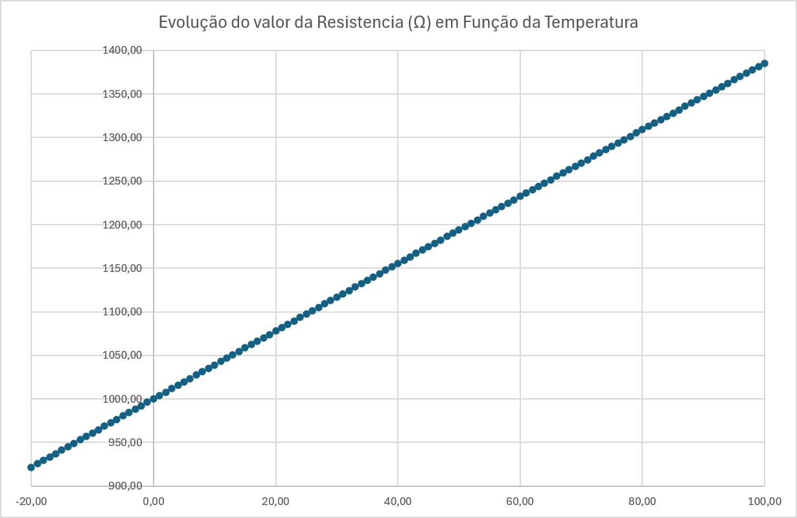
[picture p11: figure]

Figura 7 Reta de caracteristica RTD

Através da visualização da Figura 7, é possível verificar a curva caraterística do sensor PT1000. O comportamento e a precisão deste componente são estritamente regulados pela norma IEC 60751, que define a relação resistência-temperatura e as respetivas bandas de tolerância de erro.

O sensor selecionado para este projeto enquadra-se na Classe B da referida norma. Como estes sensores são fabricados segundo diretrizes rigorosas, é possível garantir uma elevada fiabilidade e repetibilidade na medição da temperatura do sistema.

## Ponte de Wheatstone

O circuito escolhido para converter a variação de resistência da PT1000 foi uma ponte de wheatstone com linearização. O circuito foi implementado com o objetivo de reduzir o impacto que uma ponte de Wheatstone causa, devido a tolerância dos seus componentes, afetando assim a linearidade da sonda PT1000, foi usada uma PT1000 em detrimento de uma PT100, devido ao sobreaquecimento da célula, pois segundo a lei de ohm, quanto maior a resistência de um componente, menor a corrente que o atravessa, sendo este um ponto de especial atenção.

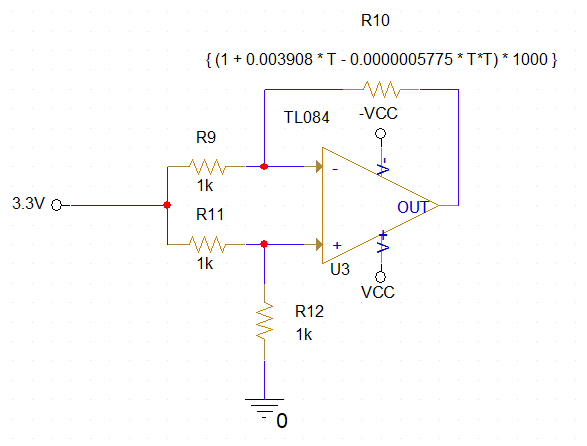
[picture p12: figure]

Figura 8 Ponte de Wheatstone com linearização

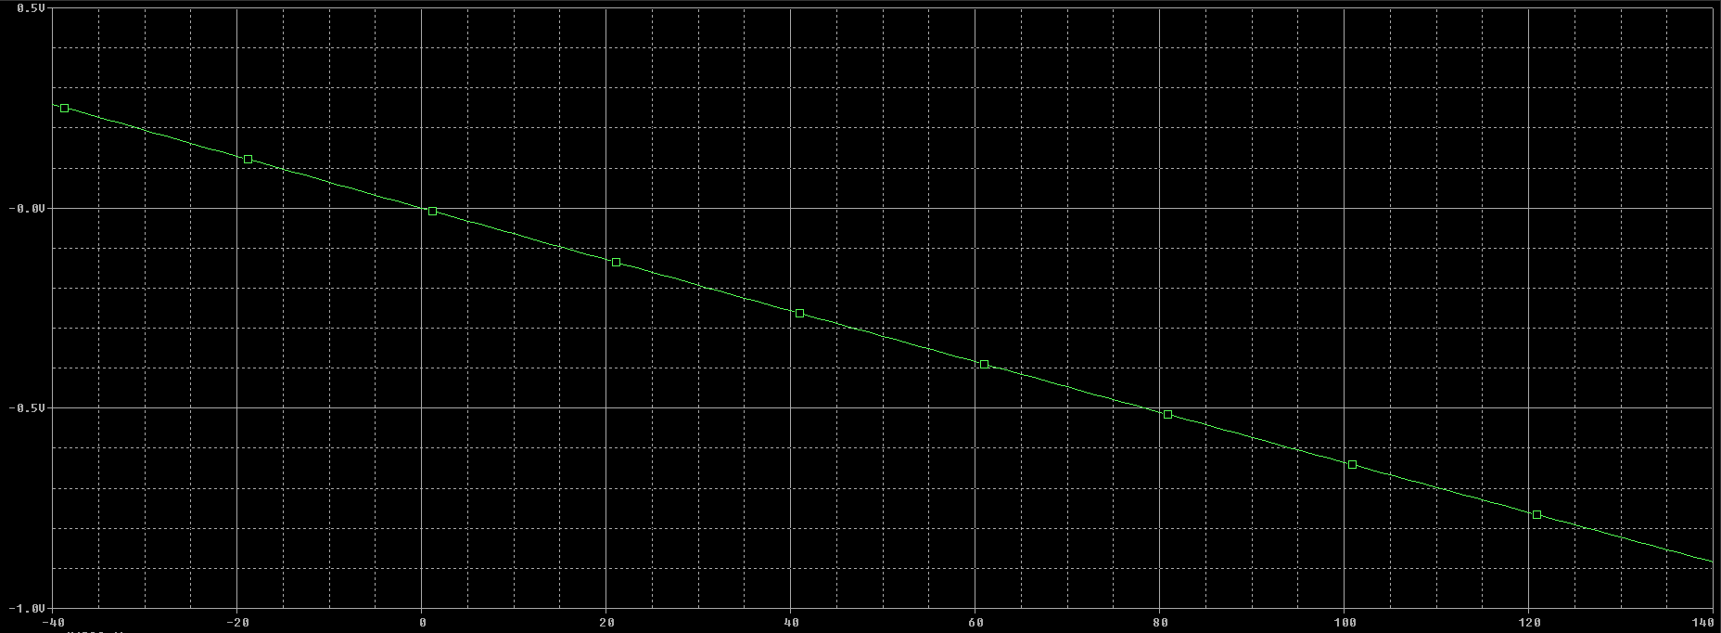
[picture p13: figure]

A ponte de wheaston da figura x com linearização analógica pode ser descrita através da seguinte equação V_0 =-3.3/2*(At + Bt²) . [7]

Figura 9 Reta Saída ponte de Wheatstone linearizada - Pspice

Figura 10 Reta Saída ponte de Wheatstone linearizada - Calculado

## Condicionamento de sinal

Com o intuito de condicionar o sinal de modo ao mesmo ser compatível com o intervalo de leitura do ADC do microcontrolador [0;3.3] V, dimensionamos o circuito de modo a ler com o seguinte intervalo de temperaturas [-20, 100] ºC garantindo assim uma gama de temperaturas adequada as temperaturas típicas da marmita, e permitindo uma resolução adequada.

Através de um ampliador operacional subtrator inversor com o ganho definido, conseguimos condicionar o sinal, conforme os cálculos abaixo.

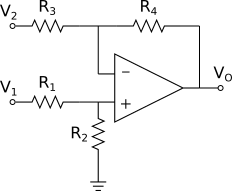
[picture p14: figure]
Amplificador subtrator - Professor Elétrico

Figura 11 Amplificador Subtrator Inversor

R_4 = R_2 = R_x & R_1 = R_3 = R_y

V_o = (R_y)/(R_x) × (V_1 - V_2 )

De modo a tensão lida pelo microcontrolador no valor mínimo (-20ºC) seja 0 V, precisamos que V_1 equivale a V_2 , sendo V_2 igual a V_o ( -20 ºC).

V_2 = V_o (-20)

V_2 = -3.3/2*((3,9083×10^(-3) )× (-20)+ (-5,775×10^(-7) ) * (-20)^2 )

V_2 = 0.130 V

Logo, V_2 tem de ser 0.1293 V, para obter este valor de tensão utilizamos um divisor de tensão, com uma resistência de 2.4kΩ ligada a 3.3V e a segunda resistência de 100Ω, conforme demostra os seguintes cálculos

V_1 = (100×3.3)/(2400+100) <=> V= 0.132 V

Não é possível obter o a tensão de 0.132 V através de resistências comercialmente disponíveis, sem usar um potenciómetro, dai a diferença de 2 mV é irrelevante.

De modo a garantir que no valor máximo de leitura não ultrapasse os 3.3V, foi definido que a 100 graus o valor de V_2 é de 3.20 V, deixando assim uma margem de segurança.

Sendo necessário calcular R_x e R_y , assumindo R_x = 10 kΩ sendo para ajudar o ganho do circuito.

V_2 = V_o (100)

V_2 = -3.3/2*((3,9083×10^(-3) )× (100)+ (-5,775×10^(-7) ) * (100)^2 )

V_2 = - 0.64 V

V_o = (R_y)/(R_x) × (V_1 - V_2 ) <=> 3.20 = (R_y)/10000 × (0.132 - (-0.64)) R_y =2412.5 Ω≈2.4 kΩ

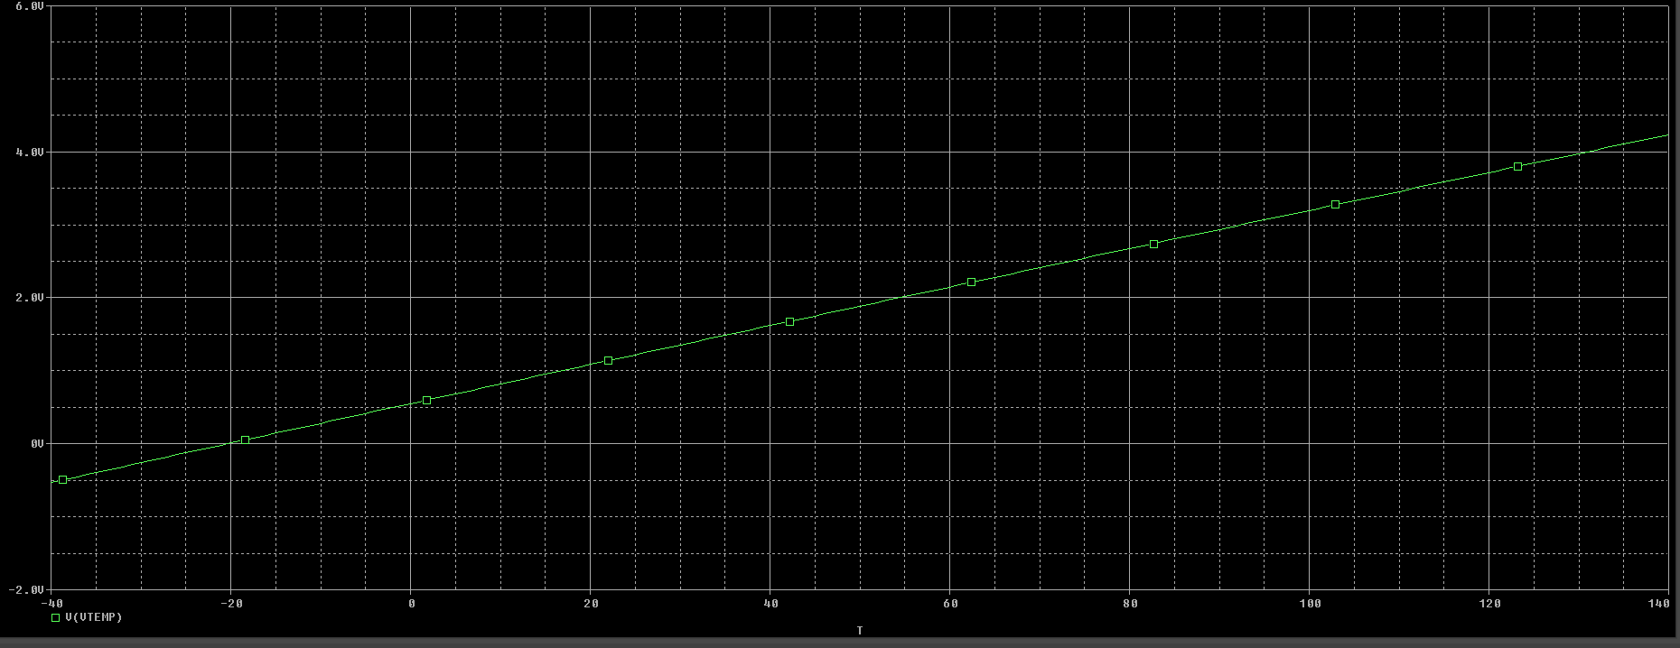
[picture p15: figure]

Figura 12 Reta Do Sinal Temperatura em Volts - Pspice

Figura 13 Reta Do Sinal Temperatura em Volts - Calculos

Sendo a equação que descreve o sinal representado na figuraX:

V_(Temperatura) (t) = 0.0266× t+0.5515

## Limitação da Tensão

Tendo em conta que o microcontrolador só consegue ler valores de tensão dentro de um intervalo específico e que o sinal já foi ajustado para esse intervalo, é necessário garantir que, em qualquer outra temperatura ou em caso de curto-circuito, o valor de tensão na porta do microcontrolador não ultrapasse os valores estipulados, a fim de evitar danos físicos no microcontrolador. Podíamos usar um díodo zener de 3,3 V e um díodo convencional para proteger o microcontrolador, mas assim perderíamos a precisão que a PT1000 nos oferece devido à tensão induzida pelo díodo convencional.

Tendo em conta estas limitações, decidimos usar um circuito de limitação de precisão, que tínhamos utilizado na unidade curricular de Eletrónica Aplicada.

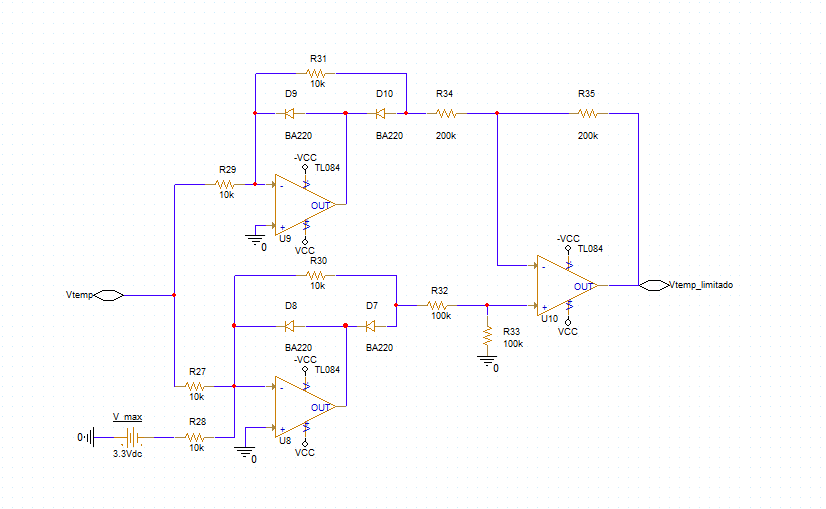
[picture p16: figure]

Figura 14 Circuito Limitador de Tensão

O circuito da Figura 14 permite limitar a tensão entre 0 V e a tensão que alimenta a R28, protegendo assim o circuito. Este limitador trabalha com díodos que saturaram o amplificador com a tensão máxima e mínima, permitindo um controlo absoluto dos limites de operação.[8]

### Simulação

Com o intuito de verificar o comportamento do limitador de tensão, através da ferramenta pspice for TI foi possível simular o comportamento do sensor para diferentes soluções e através de duas diferentes simulações conseguimos categorizar o comportamento do sistema.

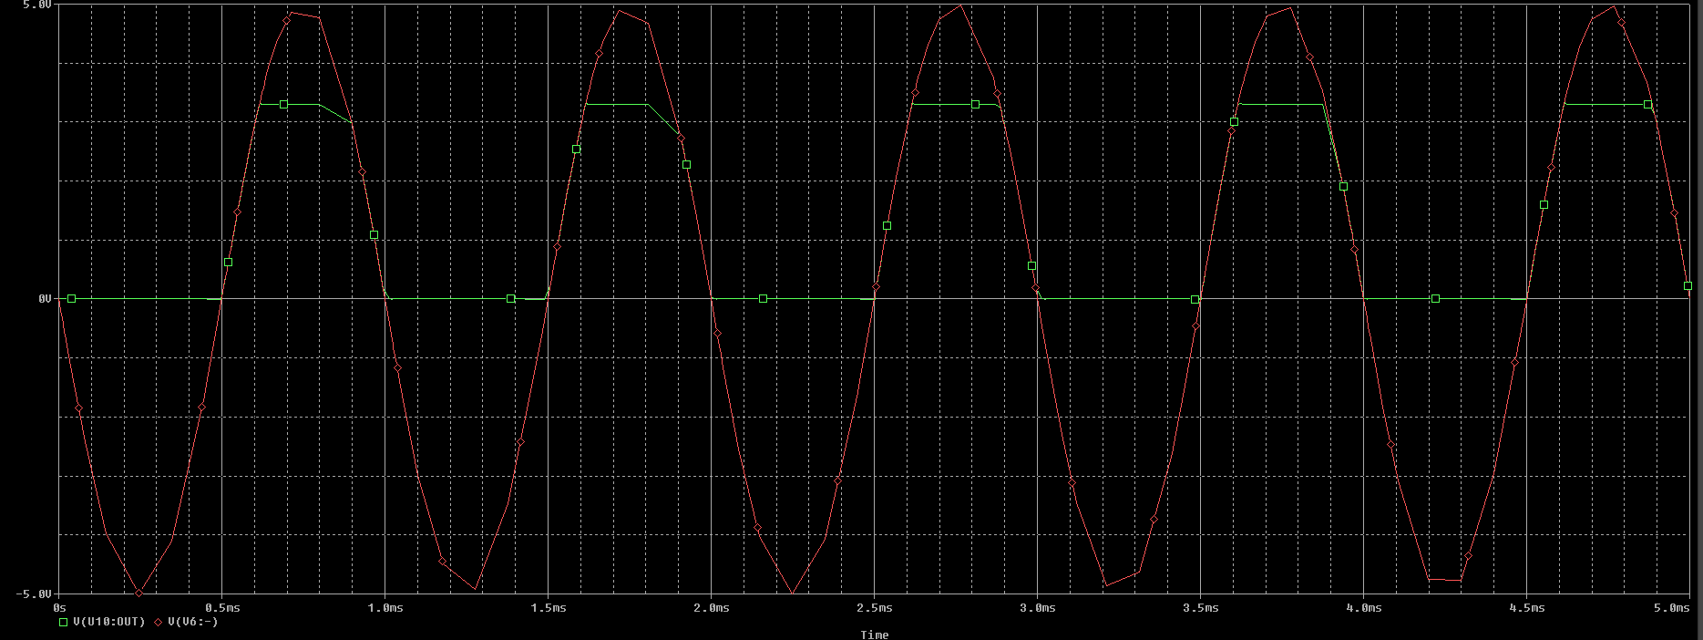
[picture p17: figure]

Numa primeira fase, foi realizada uma análise no domínio do tempo, onde é possível analisar o sinal de saída limitado entre 0 e 3.3V e o sinal de entrada de -5 a 5V.

Figura 15 Representação Sinosidal do Limitador

Por fim, através de uma análise DC Swipe, onde variamos o valor da fonte V6 entre -5 a 5 V, conseguimos obter a função de transferência do circuito.

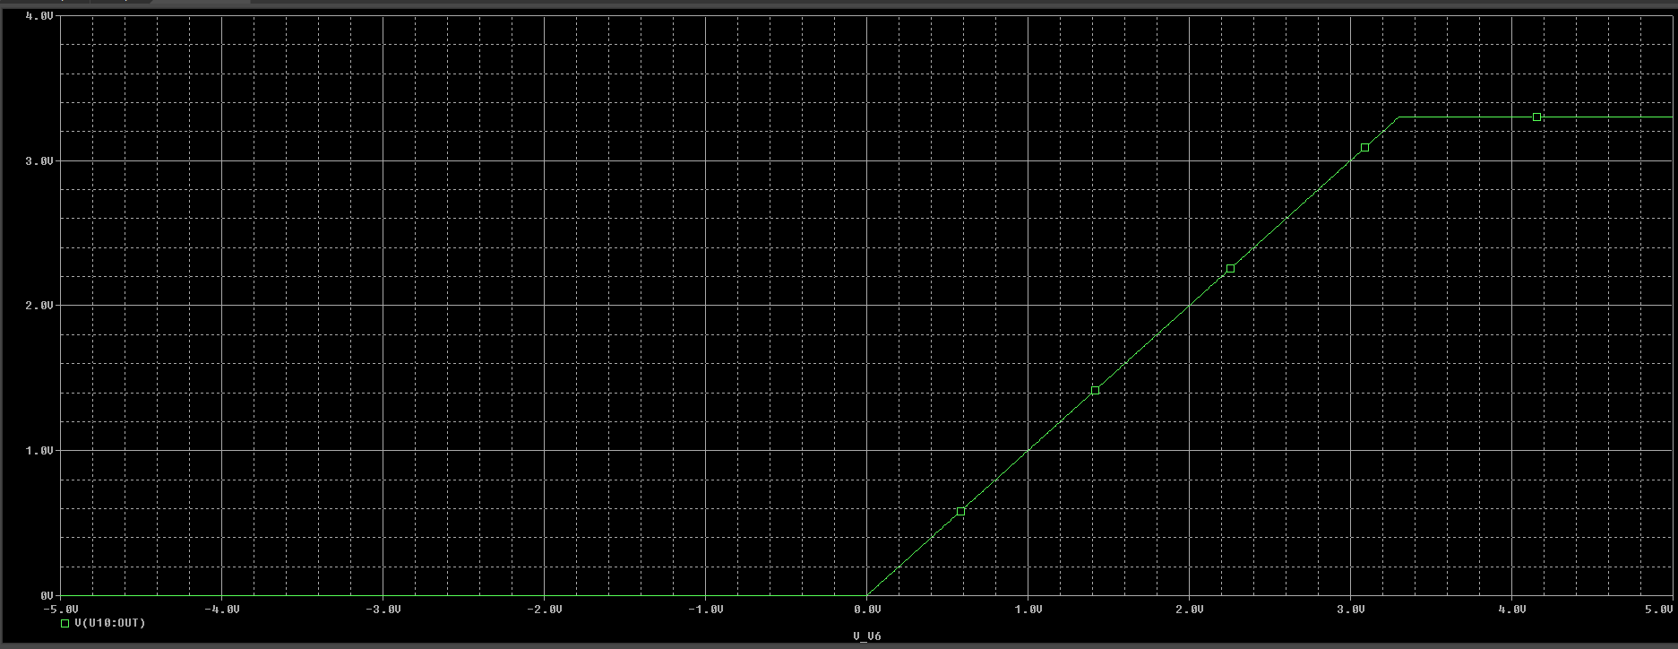
[picture p18: figure]

Figura 16 Função Tranferencia Circuito Limitador

Como podemos visualizar, na zona ativa deste circuito, não existe nenhum ganho, pois a reta é linear, com um declive de 45 graus, e qualquer valor fora da janela é ajustado ao extremo mais próximo, tendo assim noção do valor menor ou maior

# 5 Processamento e Controlo Digital

O firmware foi desenvolvido em C++ e programado num ESP32S3 através do Arduino IDE, com a inclusão do sistema operativo FreeRTOS. O programa está dividido em três módulos diferentes: leitura de dados do sensor, interface IoT e, por último, controlo da célula. Esta divisão permite uma melhor organização do código, separação de responsabilidades e um aumento da eficiência na resolução de problemas, resultando num código mais legível e de melhor qualidade.

## Lógica de Aquisição de Temperatura

O sistema operativo FreeRTOS consiste num kernel leve desenvolvido para microcontroladores que permite a execução eficiente de várias tarefas em simultâneo. No que se refere à aquisição de temperatura, é uma mais-valia, pois permite obter leituras da temperatura sem bloquear o processador, possibilitando o controlo da célula e a leitura de valores em simultâneo.[9]

Com o intuito de garantir a integridade do sistema em caso de falha de processamento ou bloqueio do firmware, foi implementado um mecanismo de supervisão de segurança, caso não seja efetuada a leitura de um novo valor do sensor num intervalo superior a 5 segundos, a célula de peltier é automaticamente desligada, garantindo a proteção do circuito.

A cada segundo, o ESP32 lê a tensão no I/O D0, efetuando uma média de vários valores lidos num determinado intervalo de tempo, conseguindo assim reduzir ruídos indesejáveis. Com este intuito, foi também utilizada a função analogReadMilliVolts () nativa do próprio ESP, que utiliza cálculos internos de modo a reduzir o erro gerado na própria conversão. Com o valor já convertido para mV, podemos calcular o valor da temperatura através da equação de saída do circuito de aquisição de sinal. Realizamos um teste para verificar o estado da PT1000, valores fora da gama operacional definida (próximos de 0 mV ou 3300 mV) indicam uma falha no circuito (cabo partido ou curto-circuito). Se todos os dados forem válidos, alteramos o valor da variável "temperatura" com recurso ao mutex, uma tecnologia de semáforos que garante que não existam duas funções a alterar o mesmo valor em simultâneo. Após um segundo, o ESP32 repete a mesma rotina.[10], [11]

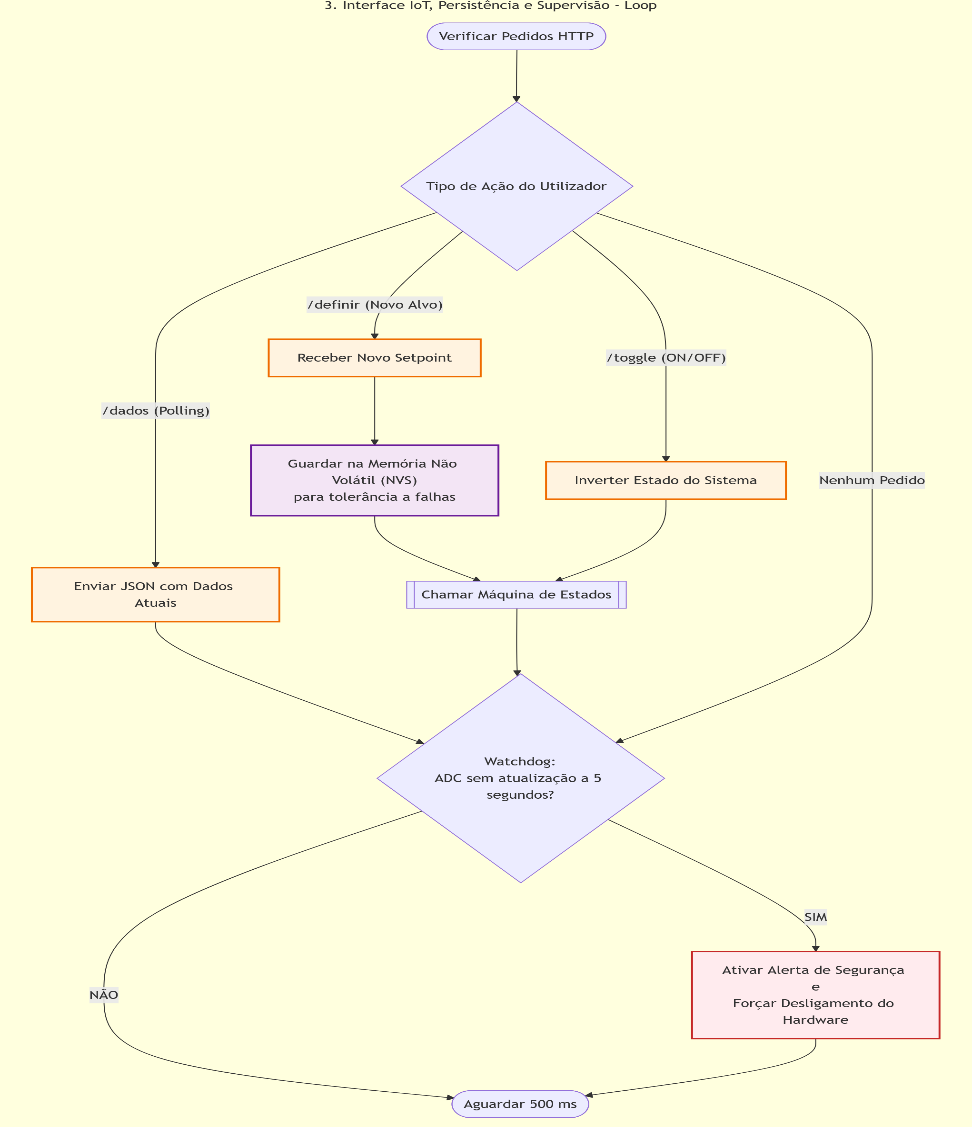
[picture p19: figure]

## Interface de Monitorização IoT

Figura 17 Fluxograma Monitorização IoT

O ESP32 tem capacidade de Bluetooth e Wi-Fi, podendo funcionar como ponto de acesso, criando a sua própria rede e comunicando com dispositivos que acedam à mesma. No modo Station, o ESP32 acede a uma rede existente e comunica com os dispositivos presentes. Por último, no modo Station/AP-coexistence, o ESP32 funciona como um ponto de acesso conectado a uma rede externa.

Para a aplicação em causa, o modo Acess Point é o mais indicado, uma vez que a câmara de temperatura pode ser controlada localmente sem dependência de infraestruturas de rede externas.

O firmware do ESP32 disponibiliza um servidor web embebido que gere uma interface de controlo, acessível através de um endereço IP dedicado. A comunicação entre o utilizador e o microcontrolador é realizada de forma assíncrona, utilizando pedidos HTTP (polling) e troca de dados estruturados em formato JSON (ver fluxograma 3) esta arquitetura permite ao utilizador visualizar os dados e alterar o estado da célula em tempo real, sem ter de recarregar a página para atualizar os valores. O sistema funciona num ciclo continuo.[12]

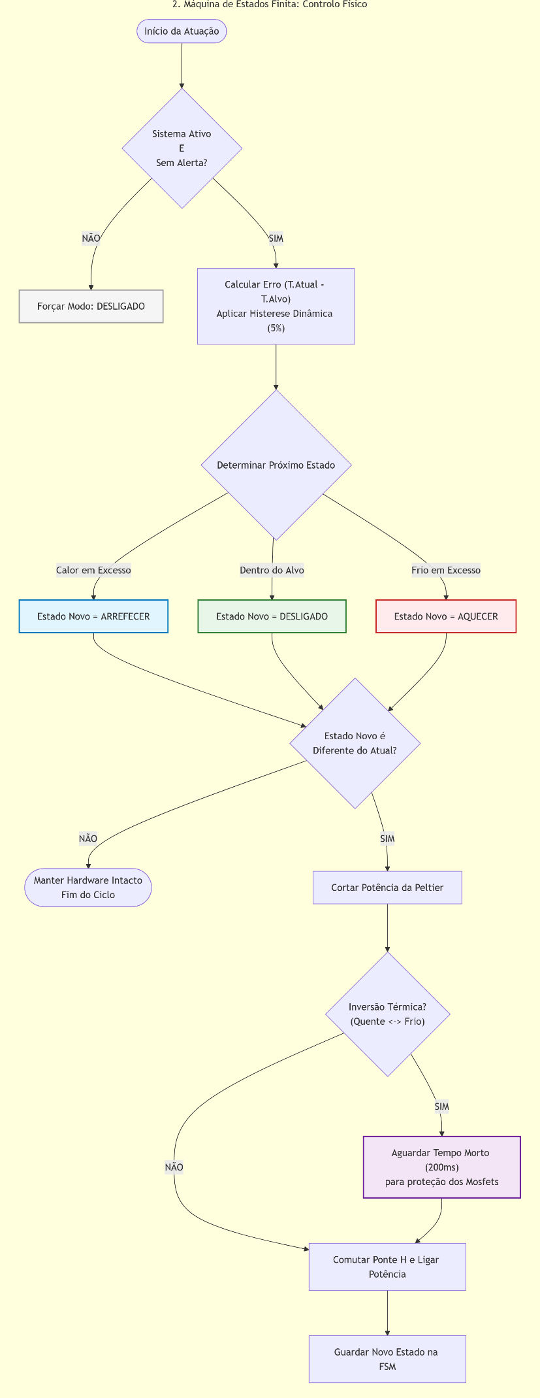
[picture p20: figure]

## Máquina de Estados de Controlo da Célula

Figura 18 Fluxograma Controlo Celula

O módulo de controlo da célula de Peltier baseia-se numa máquina de estados finitos (FSM) que opera ciclicamente, conforme ilustrado no fluxograma X. O sistema avalia continuamente as condições de funcionamento e, em caso de alerta ou desativação, força o estado "DESLIGADO". Se o sistema estiver operacional, o microcontrolador calcula o erro térmico e determina o estado seguinte (aquecimento, arrefecimento ou repouso). Para proteger os componentes de potência, é implementado um mecanismo de temporização (tempo morto) de 200 ms sempre que ocorre uma inversão térmica. Este intervalo assegura a dissipação da energia residual e previne picos de corrente durante a comutação do relé, prolongando a longevidade do hardware.

## Circuito de Potência

Tendo em conta que a célula de Peltier requer correntes elevadas, podendo atingir os 7 A em plena carga, o sistema de controlo de potência foi concebido para garantir robustez e segurança. Como os níveis de tensão e de corrente dos pinos de entrada/saída (I/O) do ESP32 são insuficientes para a ativação direta da carga, foi utilizada um controle de potência baseada num MOSFET de nível lógico (Logic Level MOSFETs).

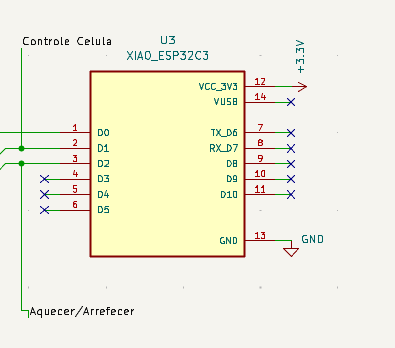
[picture p21: figure]
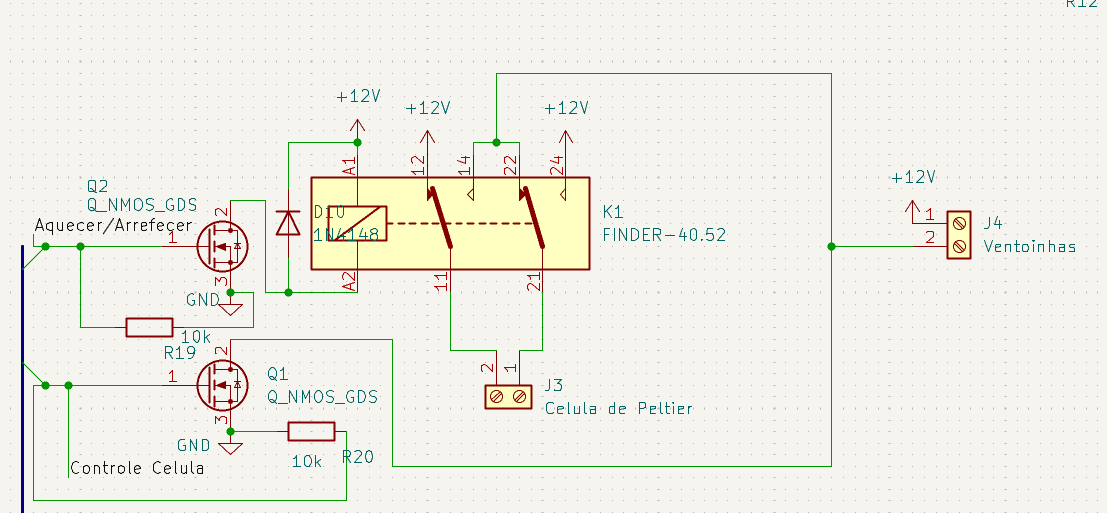
[picture p22: figure]

A estratégia de controlo adotada utiliza um relé DPDT para inverter a polaridade da corrente na célula e alternar entre os modos de aquecimento e arrefecimento. A ativação deste relé é efetuada por um segundo MOSFET, que funciona como interface entre a lógica de controlo de 3,3 V do ESP32 e a bobina de 12 V do relé. Esta arquitetura isola o microcontrolador da carga de potência, assegurando a integridade do circuito face a correntes elevadas.

Figura 19 Esquema de ligação ESP32

Figura 20 Esquema de ligação Celula

Esta topologia de circuito permite um controlo preciso da célula termoelétrica, mantendo a simplicidade e a eficiência do sistema. Para garantir a fiabilidade operacional, foram integradas resistências de pull-down nas portas dos MOSFET. Estas resistências são essenciais para evitar estados de condução incertos (flutuação) durante a inicialização do microcontrolador, garantindo que os transístores permanecem no estado de corte (OFF) até que o sinal de comando seja ativamente aplicado. Adicionalmente, esta configuração permite um desligamento imediato ao proporcionar um caminho de drenagem para a carga acumulada na capacitância interna da porta do MOSFET.

Relativamente ao acionamento do relé, foi instalado um diodo de proteção (flyback) em paralelo com a bobina. Este componente é essencial para suprimir os picos de tensão indutiva (força eletromotriz inversa) que ocorrem durante a interrupção da corrente, protegendo os semicondutores de controlo contra danos causados por sobretensões.

# 6 Implementação física e verificações experimentais

## Circuito de Alimentação

Para a geração das tensões simétricas necessárias à polarização dos amplificadores operacionais ( ±V_(CC) ) e para o correto funcionamento do limitador de tensão, foram integrados conversores CC/CC isolados. Esta topologia garante o isolamento galvânico entre os diferentes estágios do circuito, minimizando a propagação de ruído e eventuais picos de tensão. Adicionalmente, foram previstos locais na PCB para a montagem de condensadores de filtragem (de desacoplamento) na saída destes módulos, visando a redução do ripple e a estabilidade da tensão de saída sob carga.

Relativamente à alimentação de potência e lógica, optou-se pela seguinte configuração:

- Nível Lógico (3,3 V): Utilizou-se o conversor step-down Mini360, selecionado pelo seu reduzido fator de forma e elevada eficiência energética.
- Potência (12 V): A célula de Peltier é alimentada por um módulo baseado no controlador LTC3780 (conversor buck-boost), escolhido pela sua capacidade de suportar correntes até 10 A, flexibilidade na regulação da tensão de saída e mecanismos integrados de proteção contra curto-circuitos, que emitem um sinal de erro preventivo e salvaguardam a integridade dos restantes componentes. [13][14]

## Desenho do Esquema e Placa PCB

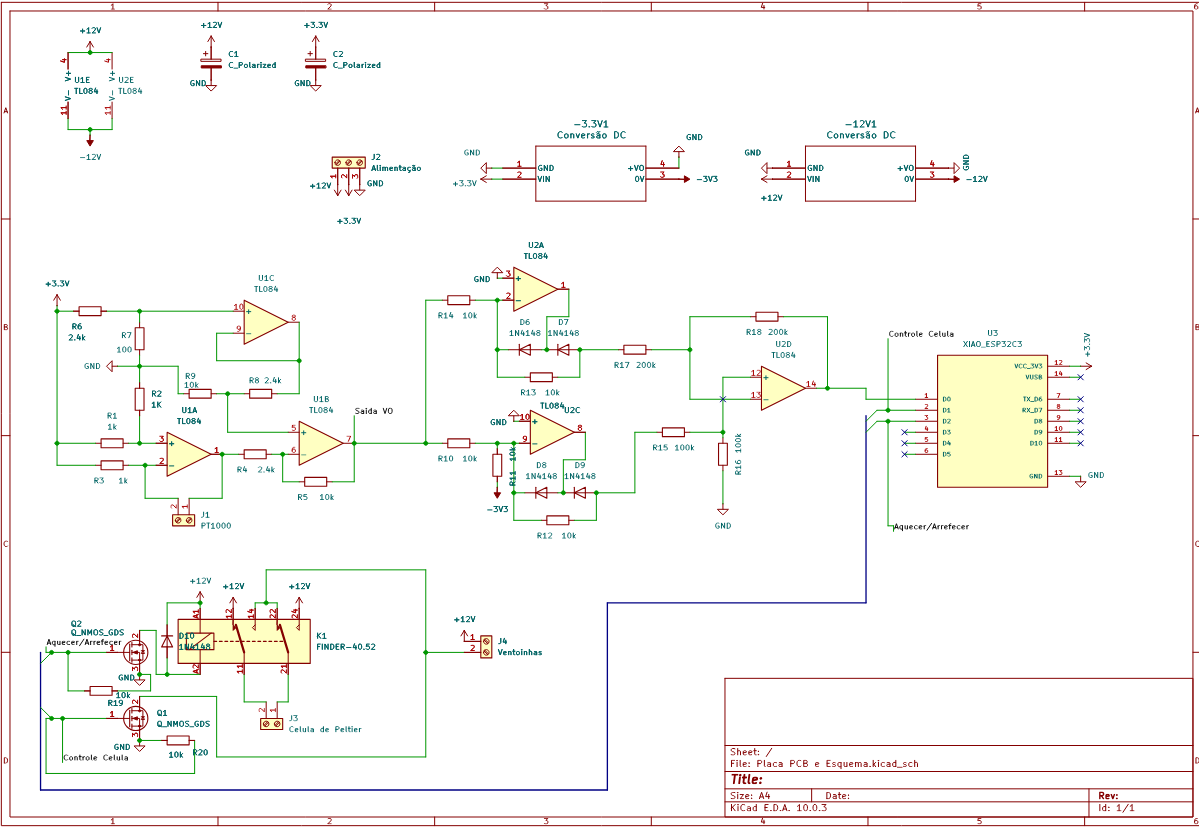
[picture p23: figure]

Figura 21Esquema eletrico projeto

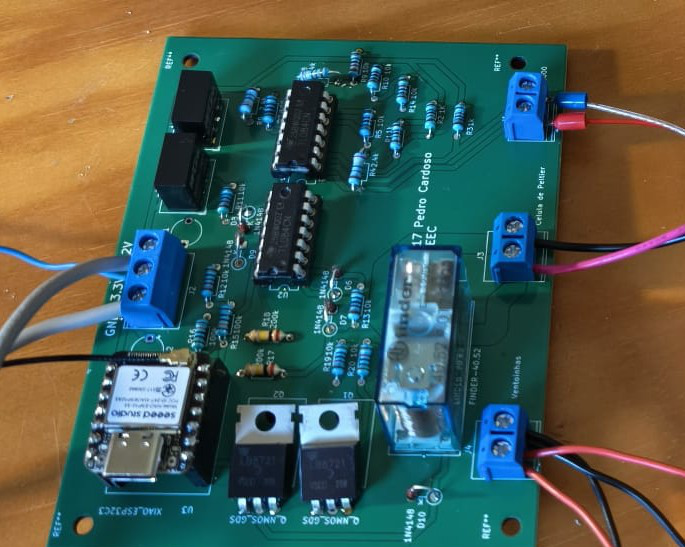
[picture p24: figure]
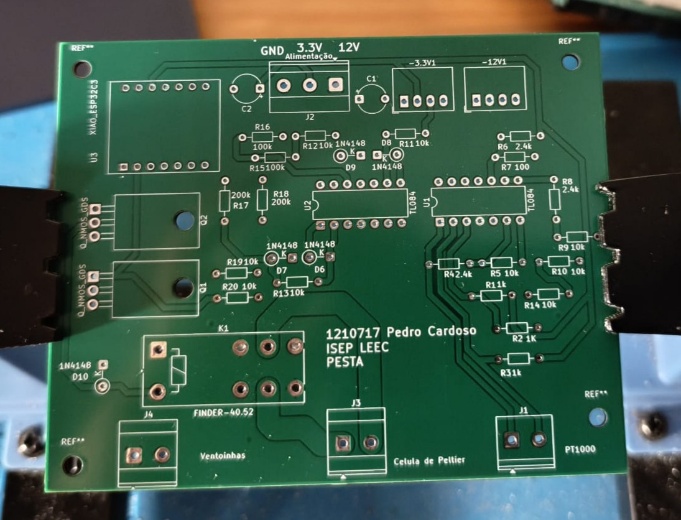
[picture p25: figure]
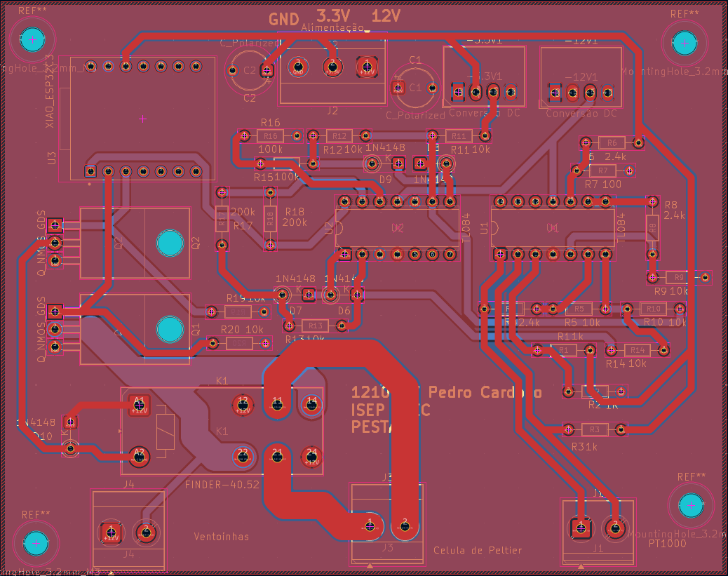
[picture p26: figure]

A implementação do sistema baseou-se no desenvolvimento de uma PCB de duas faces, concebida para otimizar a densidade dos componentes e a gestão térmica da solução. A opção por uma arquitetura double-layer foi determinante para permitir a miniaturização do dispositivo, possibilitando uma distribuição eficiente das pistas de sinal e de potência.

Uma das principais características desta placa é a utilização de camadas dedicadas aos planos de alimentação de potência. Em particular, as redes de 12 V e de massa (GND) foram implementadas por meio de extensas camadas de cobre numa das camadas da PCB. Esta configuração cumpre dois objetivos críticos de engenharia:

- Otimização do espaço: ao reservar planos contínuos para as tensões de potência, reduz-se significativamente a necessidade de pistas individuais de grande secção, libertando área útil na placa para a densa disposição dos restantes componentes lógicos;
- Gestão térmica: o cobre, devido à sua elevada condutividade térmica, funciona nestes planos como um dissipador de calor passivo. A distribuição destas correntes por planos amplos minimiza a resistência elétrica, reduz a dissipação de energia por efeito Joule e facilita a dispersão do calor gerado pelos módulos de potência, garantindo a estabilidade operacional do sistema sob carga.

Durante a elaboração da placa de cicuito impresso foram adotadas as boas praticas de desenho de PCB, principalmente a separação do circuito da célula de Peltier face ao circuito analógico de condicionamento de sinal assegurando assim uma modularidade eficiente, e minimizando a probabilidade de interferências eletromagnéticas e térmicas entre os diferentes módulos do sistema.

De notar que os esquema eletrico do projeto e a placa em questão foram desenvolvidos com recurso ao software KiCad, pois é uma solução de codigo aberto e cum elevadas funcionaliades.

## Montagem do Protótipo

Tendo em conta os requisitos de espaço, foi utilizada uma caixa de esferovite para manter a temperatura e isolar a câmara de temperatura, a qual tem uma capacidade volumétrica de aproximadamente 2,3 litros.

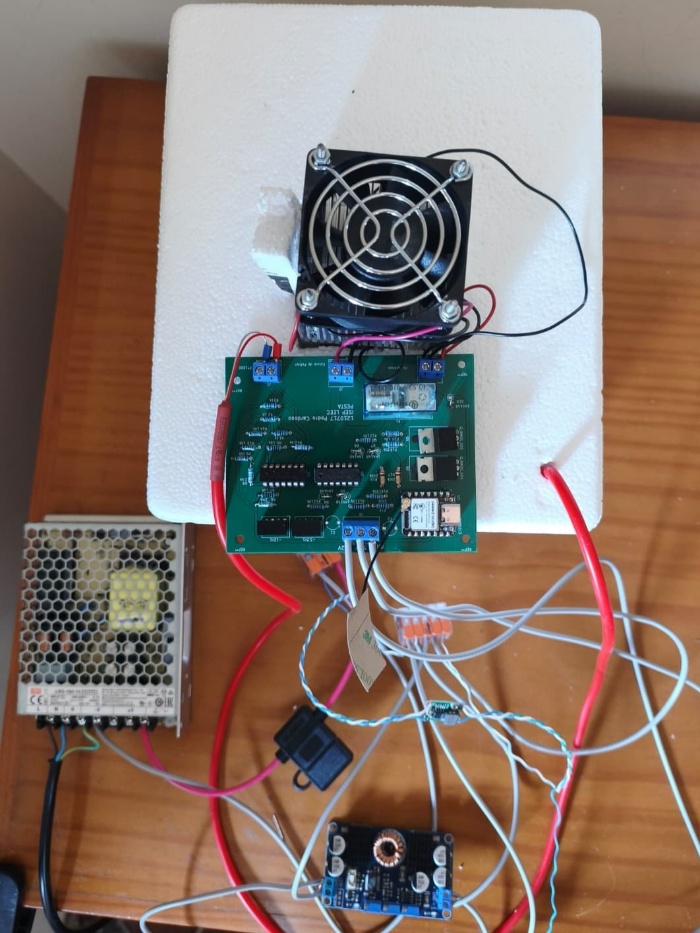
[picture p27: figure]

A implementação de duas ventoinhas no lado interior e exterior da câmara proporciona uma maior eficiência, permitindo uma melhor dissipação de calor.

Ambas as ventoinhas estão posicionadas de modo a promover a convecção forçada, com o ar a ser sugado do topo do ventilador e a incidir diretamente sobre o alumínio em contacto com a pasta térmica junto da célula. Desta forma, é possível arrefecer o lado quente e ajudar o frio a propagar-se dentro da caixa. No modo de aquecimento, o ar é forçado a passar pela fonte de calor, aquecendo o interior da caixa. Por fim, o ar quente é enviado contra o lado frio da célula, aquecendo-a.

A célula mantém sempre uma diferença de temperatura em ambos os lados e é esta diferença de temperatura que limita a capacidade de arrefecimento da célula. Por conseguinte, é necessário dissipar o calor, caso contrário, a célula irá sobreaquecer em ambos os lados, o que poderá causar danos.

De forma a melhorar a condutividade térmica da área de contacto entre os dissipadores e a célula recorreu-se à pasta térmica.

## Testes e Validação Prática

Com o intuito de testar o comportamento do sistema, foi realizado uma serie de testes para caracterizar o seu comportamento. Os dados foram capturados através da memória Ram do ESP32 e depois foram exportados para csv através da página WEB, versão disponível nos anexos.

O primeiro teste baseia-se na manutenção de uma temperatura durante +- 11 minutos (700 segundo), o projeto foi ligado com a temperatura regulada para -20 ºC

Figura 22 Resposta Térmica do Sistema Peltier com Alvo de -20 °C.

O gráfico acima mostra a curva da temperatura no interior da câmara térmica num período de teste de aproximadamente 12 minutos (712 segundos), com a temperatura regulada para -20 °C. Através da analisa é possivel identificar dois momentos diferentes no comportamento do sistema.

Na primeira fase, que corresponde ao arrefecimento inicial (0 a ~170 segundos), o módulo Peltier extrai calor da câmara durante os primeiros três minutos de funcionamento, resultando numa descida da temperatura ambiente de 26,4 °C para um valor mínimo de 23,4 °C.

Na segunda fase, designada por "saturação e aquecimento" (com uma duração aproximada de 170 a 712 segundos), o comportamento do sistema inverteu-se em relação à fase anterior, com a temperatura a começar a subir a partir do terceiro minuto em vez de continuar a descer. Em vez de continuar a diminuir até aos -20 °C, a temperatura inicia um processo de subida de forma praticamente linear, atingindo os 27,9 °C no final do ensaio.

Em conclusão, os dados recolhidos indicam que o sistema não atingiu a temperatura alvo de -20 °C. A inversão térmica observada a partir dos 170 segundos sugere, como hipótese mais provável, uma saturação do dissipador no lado quente da célula de Peltier, embora outras causas de ineficiência térmica não possam ser excluídas. Em casos de ineficiência do sistema de dissipação de calor para o exterior, o calor é transferido para a face fria do módulo, resultando no aquecimento indesejado do interior da câmara, pelo que uma melhoria no dissipador ou no sistema de ventilação seria o próximo passo a considerar.

O segundo teste teve como objetivo avaliar o comportamento do sistema em modo de aquecimento e validar a capacidade de atuação bidirecional da célula de Peltier. O projeto foi ligado com a temperatura regulada para 80 °C, permitindo que o sistema estabilizasse nas proximidades deste valor. Decorridos sensivelmente 500 segundos de ensaio, o valor de referência foi alterado para 50 °C através da interface Web, com o intuito de demonstrar a capacidade do sistema em inverter o sentido de atuação e arrefecer ativamente a câmara térmica. A monitorização manteve-se por um período total de aproximadamente 920 segundos (15,3 minutos).

Figura 23 Teste 2 - Temperatura ambiente - 80 ºC - 70ºC

O gráfico acima mostra a curva da temperatura no interior da câmara térmica ao longo do período de teste, com a temperatura regulada inicialmente para 80 °C e, a meio do ensaio, para 50 °C. Através da análise é possível identificar quatro fases distintas no comportamento do sistema.

Na primeira fase, correspondente ao aquecimento inicial (0 a ~350 segundos), a célula de Peltier transfere calor para o interior da câmara, elevando a temperatura de 28,47 °C para um valor máximo de 77,62 °C, ao longo de aproximadamente 5,5 minutos.

Na segunda fase (~350 a 500 segundos), o sistema entra num regime de quase-estabilização, oscilando entre os 73,2 °C e os 77,6 °C sem, no entanto, atingir o valor alvo de 80 °C, o que sugere uma limitação na capacidade de transferência térmica idêntica à identificada no primeiro teste.

Na terceira fase (~500 a 820 segundos), após a alteração do alvo para 50 °C, observa-se uma inversão clara do comportamento do sistema: a célula de Peltier reverte o sentido de atuação e passa a extrair calor da câmara, fazendo descer a temperatura de forma contínua e acentuada, dos 73,7 °C até um valor mínimo de 45,5 °C. Este resultado valida a capacidade de atuação bidirecional do sistema, confirmando a correta comutação da ponte H entre os modos de aquecimento e arrefecimento.

Na quarta e última fase (~820 a 920 segundos), a temperatura recupera até aos 49,86 °C, valor já dentro da banda de histerese definida para o alvo de 50 °C, confirmando que o sistema convergiu para a região de estabilização pretendida. Após este pico de aproximação, observa-se uma ligeira deriva descendente até aos 46,55 °C no final do ensaio, explicada pelo facto de, dentro da banda de histerese, a célula de Peltier permanecer sem alimentação, ficando a temperatura sujeita às perdas térmicas para o ambiente sem compensação ativa.

Em conclusão, os dados recolhidos confirmam a capacidade do sistema para operar em ambos os sentidos de atuação, tendo sido possível inverter o comportamento térmico da câmara de um regime de aquecimento sustentado para um regime de arrefecimento ativo, aproximando-se do novo valor de referência. Verifica-se, contudo, um desvio inicial acentuado (undershoot) de cerca de 4,5 °C abaixo do alvo antes da aproximação final, e uma ligeira deriva fora da banda de histerese na fase final, o que sugere que um ajuste mais fino da margem de histerese ou da capacidade de dissipação poderia melhorar a precisão da estabilização em regime permanente.

O último teste tem como objetivo comparar a curva de aquecimento com a de arrefecimento, aquecendo a (TEC) até ao valor máximo e depois de estabilizar, alterar para o modo frio e estabilizar o sistema na mesmo temperatura que o mesmo alcance.

Figura 24 Teste 3 - Curva de Aquecimento vs Arrefecimento

Com base nos dados experimentais recolhidos, é possível observar claramente o comportamento dinâmico do sistema térmico durante um ciclo completo de operação. Na fase de aquecimento, a temperatura ascende de forma consistente desde os 35,3 °C até atingir um patamar máximo de aproximadamente 95,5 °C, num intervalo de cerca de 1270 segundos (aproximadamente 21 minutos). Após este pico térmico, a atuação do sistema para a fase de arrefecimento provoca uma descida acentuada e controlada da temperatura, que acaba por estabilizar na casa dos 18 °C a partir dos 2450 segundos. Este perfil transiente valida a capacidade da TEC e da respetiva malha de controlo em gerir amplitudes térmicas severas de forma eficaz, garantindo tanto o aquecimento necessário para a regeneração alimentar como o arrefecimento para conservação, cumprindo integralmente os requisitos delineados para o projeto.

# 7 Conclusões

## Síntese de Resultados

O presente trabalho culminou no desenvolvimento com sucesso de um protótipo funcional de uma marmita térmica inteligente com conectividade IoT, cumprindo integralmente os objetivos e requisitos inicialmente delineados nas diretrizes do projeto. A abordagem metodológica adotada permitiu integrar conceitos avançados de eletrónica analógica de precisão, eletrónica de potência, sistemas digitais embebidos e programação concorrente em tempo real.

No domínio do hardware, a conceção e implementação física da placa de circuito impresso (PCB) biface (double-layer) demonstraram eficácia na gestão de restrições de espaço e de integridade de sinal. A estratégia de estender os planos de cobre dedicados às redes de potência de 12 V e de massa (GND) revelou-se crucial para mitigar os ruídos de comutação e otimizar a dissipação térmica da placa. No estágio analógico, a topologia de condicionamento baseada na Ponte de Wheatstone, combinada com o circuito delimitador de precisão (Precision Bounding Circuit) com amplificadores operacionais TL084, garantiu uma leitura linear e fidedigna do sensor RTD PT1000, confinando com total segurança o sinal entregue ao ADC do microcontrolador XIAO ESP32-S3 no intervalo seguro de 0 V a 3,3 V.

No âmbito do software e controlo digital, o firmware desenvolvido sob a arquitetura do sistema operativo em tempo real FreeRTOS provou ser altamente robusto. A segregação de tarefas de leitura e processamento térmico face à tarefa de gestão do servidor Web foi otimizada recorrendo a mecanismos de sincronização por exclusão mútua (Mutex). Adicionalmente, as rotinas de proteção por software — nomeadamente a temporização de salvaguarda (dead-time) na comutação da polaridade do relé de inversão e o mecanismo de watchdog para deteção de falhas no sensor — garantiram a integridade do hardware contra picos de corrente e transientes severos.

Por fim, os ensaios laboratoriais e a validação experimental comprovaram o excelente desempenho dinâmico da malha de controlo térmico (ON/OFF com histerese). Conforme evidenciado pelos dados empíricos recolhidos, o sistema demonstrou capacidade de elevar a temperatura interna da câmara térmica de um patamar inicial de 35,3 °C até um pico máximo de regeneração alimentar de 95,5 °C em aproximadamente 1270 segundos (~21 minutos). Na vertente oposta de conservação, o sistema atuou na fase de arrefecimento de modo a estabilizar de forma precisa e controlada a temperatura na vizinhança dos 18 °C. Este comportamento transiente valida a eficácia térmica da célula de Peltier e o acerto do algoritmo digital de controlo perante amplitudes térmicas exigentes.

## Análise de Custos do Protótipo

A avaliação económica do projeto constitui um pilar fundamental na engenharia, permitindo aferir a viabilidade financeira da solução face às alternativas industriais existentes. Para este efeito, realizou-se um levantamento minucioso dos custos associados à aquisição dos componentes utilizados no fabrico do protótipo laboratorial.

Tabela 1 Lista de Materiais (BOM) e Balanço de Custos do Protótipo

Componente / Descrição | Quantidade | Preço Unit. (€) | Custo Total (€)
Fonte de Alimentação Comutada (MEAN WELL LRS-100-15) | 1 | 34,45 | 34,45
Microcontrolador (XIAO ESP32-S3 c/ Wi-Fi e BT) | 1 | 8,95 | 8,95
Sensor de Temperatura RTD (PT1000) | 1 | 4,76 | 4,76
Estrutura da Câmara (Caixa de esferovite) | 1 | 16,24 | 16,24
Conversor DC-DC Buck/Boost (LTC3780 10A) | 1 | 14,22 | 14,22
Sistema de Arrefecimento (2x Dissipadores, 2x Ventoinhas 12V 60mm, 2x Grelhas) | Lote | - | 23,18
Conversores DC-DC Isolados (B0303S-1WR3 e B1212S-1WR3) | 2 | ~2,09 | 4,18
Conversor Step-Down (Mini360) | 1 | 1,59 | 1,59
Amplificadores Operacionais (TL084) | 2 | 2,14 | 4,28
Transístores de Potência (MOSFET IRLB8721) | 2 | 2,28 | 4,56
Relé de Inversão (2INV 8A 12VDC) | 1 | 1,19 | 1,19
Componentes Passivos e Semicondutores (Resistências diversas e Diodos 1N4148) | Lote | - | 4,63
Conectores e Suportes (Bornes de Parafuso e Suportes CI 14 Pinos) | Lote | - | 1,93
Custo Total Estimado | | | 124,16€

(Nota: Os valores apresentados incluem o Imposto sobre o Valor Acrescentado — IVA — à taxa legal em vigor de 23%.)

O custo total final para a materialização do protótipo laboratorial fixou-se em 124,16 €. Numa análise de engenharia económica, este valor deve ser interpretado considerando o contexto de desenvolvimento unitário. A aquisição de componentes em regime de retalho e a produção individualizada de protótipos acarretam custos substancialmente superiores quando comparados com os padrões da indústria de produção em massa.

Num cenário de industrialização e transição para uma escala de produção em série (escala de milhares de unidades), prevê-se uma redução drástica no custo final do produto (estimada entre 60% a 70%). Módulos como a fonte de alimentação MEAN WELL, conversores DC-DC e o próprio microcontrolador ESP32-S3 passariam a ser adquiridos diretamente em lote de distribuição grossista (bulk), reduzindo o seu custo unitário para uma fração do valor atual. Adicionalmente, a integração dos circuitos de conversão de tensão (através do design nativo dos circuitos integrados diretamente na PCB principal, em vez de recorrer a módulos secundários como o LTC3780 ou o Mini360) otimizaria não só o custo de montagem industrial (Pick and Place), mas também a fiabilidade global do hardware. Desse modo, a solução proposta demonstra elevado potencial de viabilidade de mercado, posicionando-se como uma alternativa tecnologicamente superior e economicamente competitiva face às marmitas térmicas convencionais desprovidas de inteligência e controlo remoto.

## Propostas de Melhoria

Apesar de o protótipo desenvolvido demonstrar plena funcionalidade e robustez na validação experimental, o processo de engenharia pressupõe uma melhoria contínua. Como tal, identificam-se diversas linhas de investigação e otimizações técnicas para trabalhos futuros, categorizadas nas vertentes de hardware, software e análise analítica:

- Implementação de Análise de Incertezas via Simulação de Monte Carlo: Uma das melhorias metodológicas mais significativas consiste na aplicação de uma simulação estocástica de Monte Carlo ao modelo matemático do circuito de condicionamento de sinal. Este estudo estatístico permitirá prever o impacto cumulativo das tolerâncias de fabrico dos componentes passivos (por exemplo, desvios de ±1% ou ±5% nas resistências da Ponte de Wheatstone e do estágio do TL084) sobre a precisão final da leitura térmica. Através desta análise, será possível determinar analiticamente a probabilidade de erro de quantização e otimizar os critérios de seleção de componentes sem a necessidade de exaustivos testes físicos em ambiente laboratorial.
- Otimização Energética e Eficiência Térmica: O rendimento global do sistema pode ser significativamente incrementado através de melhorias no isolamento térmico da câmara. A substituição da estrutura de esferovite por painéis isolantes de vácuo (VIP) ou poliuretano injetado de alta densidade minimizaria as perdas por condução e convecção. Adicionalmente, ao nível do hardware, a integração de transístores MOSFET de potência com menor resistência em condução ( R_(DS(on)) ) reduziria as perdas por efeito Joule na própria PCB, diminuindo a necessidade de dissipação passiva no circuito de potência.

# 8 Referências

[1] Ariat, «Termistores NTC: Noções básicas, recursos, símbolos e aplicações». Acedido: 2 de julho de 2026. [Em linha]. Disponível em: https://www.ariat-tech.pt/blog/Understanding-NTC-Thermistors-Basics,Features-and-Applications.html

[2] «Características do Termistor e Aplicações em Circuitos». Acedido: 2 de julho de 2026. [Em linha]. Disponível em: https://www.ntclcr.com/pt/thermistor-characteristics-and-circuit-applications

[3] Rosana Guse, «O que é um termopar? Funcionamento, tipos e como testar». Acedido: 2 de julho de 2026. [Em linha]. Disponível em: https://www.makerhero.com/blog/o-que-e-um-termopar/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

[4] «Noções básicas sobre RTD». Acedido: 2 de julho de 2026. [Em linha]. Disponível em: https://www.te.com/pt/products/sensors/temperature-sensors/resources/understanding-rtds.html#chapter-1-dl

[5] «ESP32-S3 Series Datasheet 2.4 GHz Wi-Fi + Bluetooth ® LE SoC Supporting IEEE 802.11 b/g/n (2.4 GHz Wi-Fi) and Bluetooth ® 5 (LE) Including», 2023. [Em linha]. Disponível em: www.espressif.com

[6] «INTERNATIONAL STANDARD NORME INTERNATIONALE Industrial platinum resistance thermometers and platinum temperature sensors Thermomètres à résistance de platine et capteurs hermométriques de platine industriels», 2022. [Em linha]. Disponível em: www.iec.ch

[7] Ricardo, «Signal conditioning». [Em linha]. Disponível em: https://www.eeeguide.com/signal-conditioning-system/

[8] «Non-linear Amplifiers (Limiters)».

[9] Ltd. Espressif Systems (Shanghai) Co., «FreeRTOS Overview». Acedido: 7 de julho de 2026. [Em linha]. Disponível em: https://docs.espressif.com/projects/esp-idf/en/v6.0.2/esp32/api-reference/system/freertos.html

[10] Ltd. Espressif Systems (Shanghai) Co., «ADC», 2026. Acedido: 7 de julho de 2026. [Em linha]. Disponível em: https://docs.espressif.com/projects/arduino-esp32/en/latest/api/adc.html

[11] RandomNerdTutorials.com, «ESP32 FreeRTOS Mutex – Getting Started (Arduino IDE)». Acedido: 7 de julho de 2026. [Em linha]. Disponível em: https://randomnerdtutorials.com/esp32-freertos-mutex-arduino/

[12] Ltd. Espressif Systems (Shanghai) Co., «Wi-Fi», 2026.

[13] Analog Devices, «LTC3780». Acedido: 8 de julho de 2026. [Em linha]. Disponível em: https://www.analog.com/en/products/ltc3780.html

[14] «MINI-360». [Em linha]. Disponível em: https://www.matts-electronics.com

Todos os ficheiros, simulações e código relevantes para o projeto podem ser consultados no seguinte reportório do GitHub:

- https://github.com/PFOC2203/Sistema-de-Controlo-de-Temperatura-utilizando-Celula-de-Peltier.git

Histórico

- 13 de julho de 2026, Versão 1.0, 1210717@isep.ipp.pt
