PFOC2203/Sistema-de-Controlo-de-Temperatura-utilizando-Celula-de-Peltier/Relatorio/Diagrama de Blocos.pptx

Aquisição e Condicionamento (PT1000)

Unidade de Processamento (ESP32)

Aquecer /Arrefecer
e
Controlo PWM

Circuito de controlo da célula de Peltier

(0V a 3,3V)

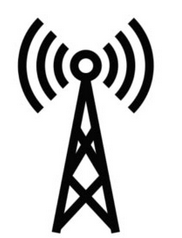
[picture p28: figure]
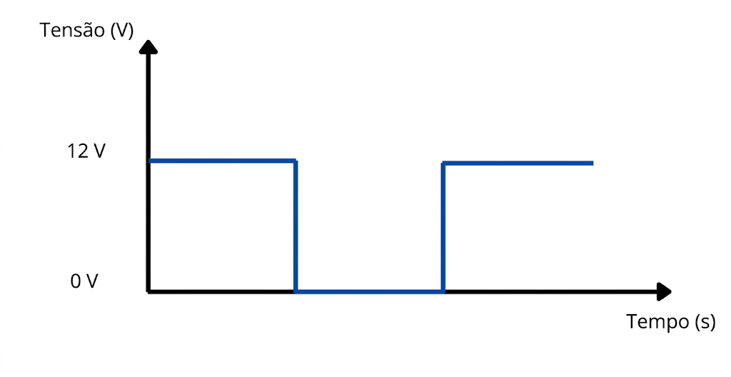
[picture p29: figure]

Página WEB para controlo do sistema

Célula de Peltier
