PFOC2203/Sistema-de-Controlo-de-Temperatura-utilizando-Celula-de-Peltier/Calculos/Simulação Pspice/P100_DATA_AQUISITON.png

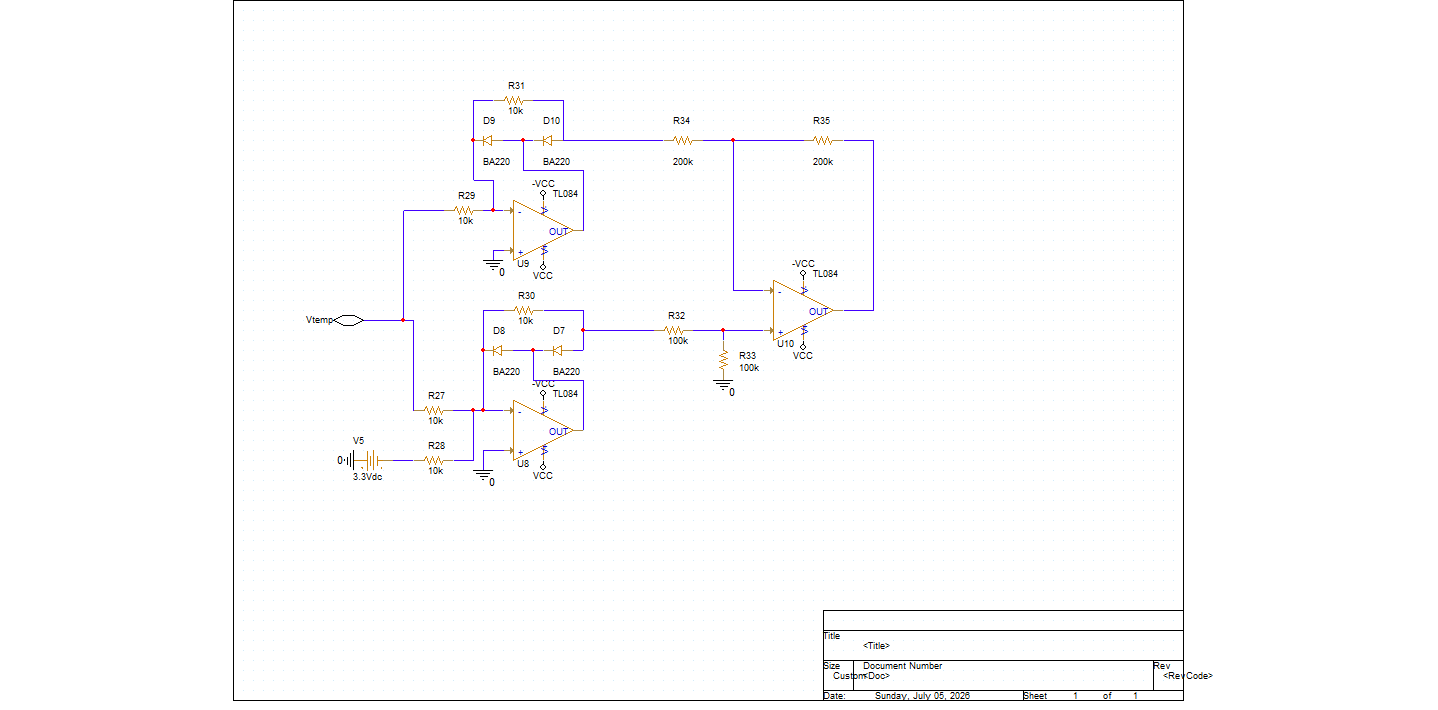
Calculos/Simulação Pspice/P100_DATA_AQUISITON.png
