PFOC2203/Sistema-de-Controlo-de-Temperatura-utilizando-Celula-de-Peltier/Hardware/Placa Finalizada.jpeg

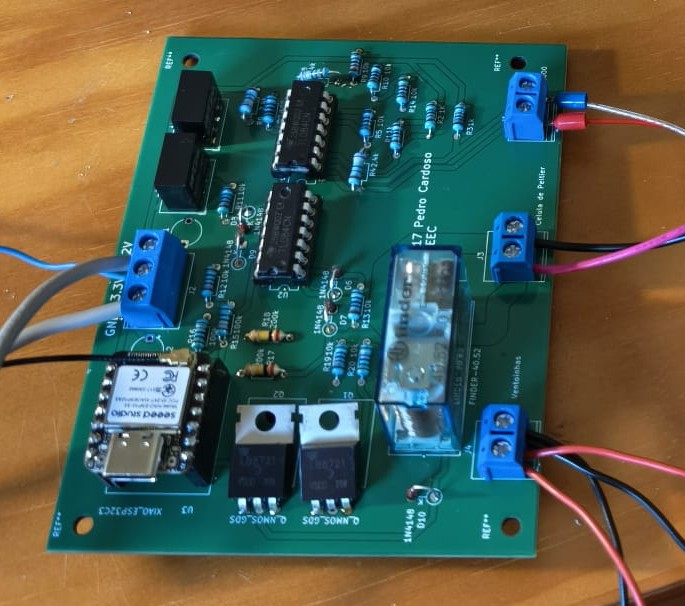
Hardware/Placa Finalizada.jpeg
