PFOC2203/Sistema-de-Controlo-de-Temperatura-utilizando-Celula-de-Peltier/Software/Aquisição de temperatura.png

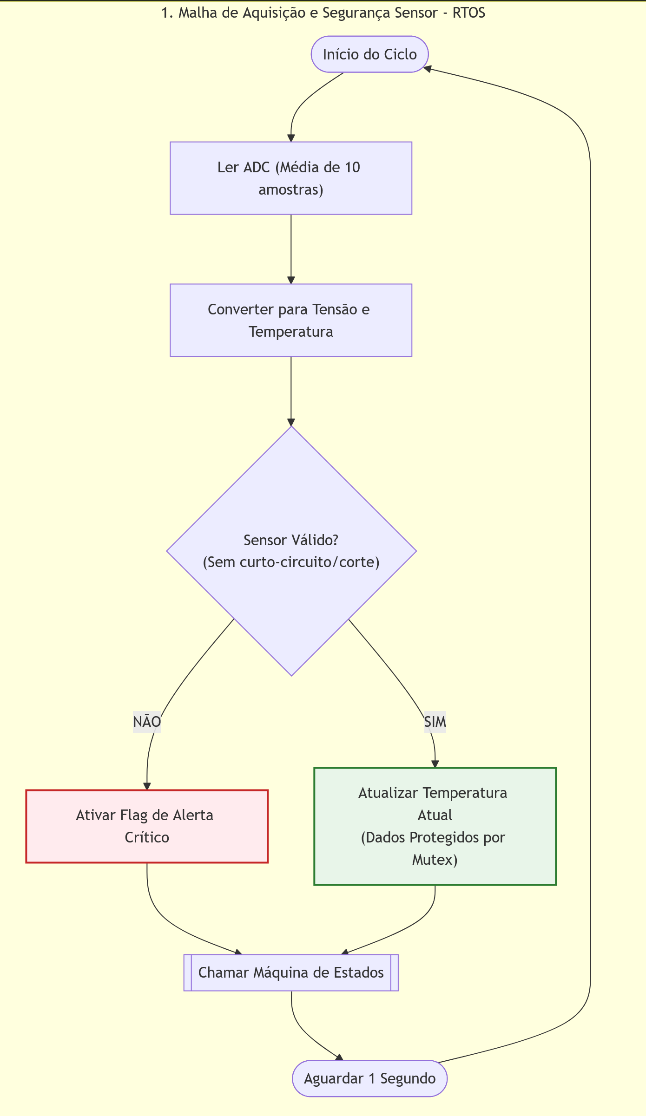
Software/Aquisição de temperatura.png
