PFOC2203/Sistema-de-Controlo-de-Temperatura-utilizando-Celula-de-Peltier/Hardware/Teste2.csv

tempo_s | temperatura_atual | temperatura_alvo | estado
0 | -0,6 | 20.00 | Desligado
10 | -0,63 | 20.00 | Desligado
20 | 28,47 | 20.00 | A Arrefecer
30 | 27,45 | 100.00 | A Aquecer
40 | 28,21 | 80.00 | A Aquecer
50 | 29,52 | 80.00 | A Aquecer
60 | 31,08 | 80.00 | A Aquecer
70 | 32,66 | 80.00 | A Aquecer
80 | 34,91 | 80.00 | A Aquecer
90 | 37,21 | 80.00 | A Aquecer
100 | 39,25 | 80.00 | A Aquecer
110 | 41,6 | 80.00 | A Aquecer
120 | 43,82 | 80.00 | A Aquecer
130 | 46,08 | 80.00 | A Aquecer
140 | 47,89 | 80.00 | A Aquecer
150 | 50,08 | 80.00 | A Aquecer
160 | 51,78 | 80.00 | A Aquecer
170 | 53,76 | 80.00 | A Aquecer
180 | 55,64 | 80.00 | A Aquecer
190 | 56,96 | 80.00 | A Aquecer
200 | 58,49 | 80.00 | A Aquecer
210 | 60,32 | 80.00 | A Aquecer
220 | 61,75 | 80.00 | A Aquecer
230 | 63,01 | 80.00 | A Aquecer
240 | 64,44 | 80.00 | A Aquecer
250 | 65,66 | 80.00 | A Aquecer
260 | 66,72 | 80.00 | A Aquecer
270 | 67,98 | 80.00 | A Aquecer
280 | 69,32 | 80.00 | A Aquecer
290 | 70,33 | 80.00 | A Aquecer
300 | 71,14 | 80.00 | A Aquecer
310 | 72,21 | 80.00 | A Aquecer
320 | 73,39 | 80.00 | A Aquecer
330 | 74,34 | 80.00 | A Aquecer
340 | 75,2 | 80.00 | A Aquecer
350 | 77,62 | 80.00 | Estabilizado
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
