PFOC2203/Sistema-de-Controlo-de-Temperatura-utilizando-Celula-de-Peltier/Hardware/Teste3.csv

tempo_s | temperatura_atual | temperatura_alvo | estado
0 | 35,31 | 100 | A Aquecer
10 | 34,02 | 100 | A Aquecer
20 | 35,47 | 100 | A Aquecer
30 | 37,61 | 100 | A Aquecer
40 | 39,77 | 100 | A Aquecer
50 | 41,73 | 100 | A Aquecer
60 | 43,82 | 100 | A Aquecer
70 | 45,78 | 100 | A Aquecer
80 | 48,13 | 100 | A Aquecer
90 | 49,95 | 100 | A Aquecer
100 | 52,14 | 100 | A Aquecer
110 | 53,69 | 100 | A Aquecer
120 | 55,61 | 100 | A Aquecer
130 | 57,19 | 100 | A Aquecer
140 | 58,98 | 100 | A Aquecer
150 | 60,17 | 100 | A Aquecer
160 | 61,87 | 100 | A Aquecer
170 | 63,06 | 100 | A Aquecer
180 | 64,55 | 100 | A Aquecer
190 | 65,77 | 100 | A Aquecer
200 | 66,84 | 100 | A Aquecer
210 | 67,96 | 100 | A Aquecer
220 | 69,18 | 100 | A Aquecer
230 | 70,01 | 100 | A Aquecer
240 | 70,55 | 100 | A Aquecer
250 | 71,98 | 100 | A Aquecer
260 | 72,49 | 100 | A Aquecer
270 | 73,66 | 100 | A Aquecer
280 | 74,4 | 100 | A Aquecer
290 | 75,26 | 100 | A Aquecer
300 | 76,11 | 100 | A Aquecer
310 | 76,64 | 100 | A Aquecer
320 | 77,48 | 100 | A Aquecer
330 | 78,46 | 100 | A Aquecer
340 | 78,86 | 100 | A Aquecer
350 | 79,4 | 100 | A Aquecer
360 | 80,23 | 100 | A Aquecer
370 | 80,87 | 100 | A Aquecer
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
