PFOC2203/Sistema-de-Controlo-de-Temperatura-utilizando-Celula-de-Peltier/Calculos/Projeto LOGBOOK.xlsx

Sheet: Custos e aquisição do material
Lista de equipamentos PESTA
Alimentação
Fonte de alimentação 12V | RS-50-12 | 16.00 € | Link (https://www.jcce.eu/pt/caixa/4933-rs-50-12) | Datasheet (https://www.jcce.eu/pt/index.php?controller=attachment&id_attachment=957)
Segunda fonte de alimentação | RS-15-12 | 11.80 € | link (https://www.jcce.eu/pt/caixa/4922-rs-15-12) | Datasheet (https://www.jcce.eu/pt/index.php?controller=attachment&id_attachment=950)
 | Total | 27.80 €
Controlo
Resistencias
PT100 | 72-11301001-0150.0050.JJ.TM | 16.00 € | Link (https://www.jcce.eu/pt/instrumentacao-diversa/9285-72-11301001-01500050jjtm?search_query=pt100&results=2) | Datasheet (https://www.guenther.eu/44e63d4a-9ea2-2134-1dbd-a9418adf1e3e/GUENTHER_Datenblatt_Produktgruppe_7X_KFT_KFW_E.pdf)
Celula | TEC1-12703 | 19.20 € | Link (https://www.jcce.eu/pt/modulos-peltier/8471-tec1-12703?search_query=peltier&results=13) | Datasheet (https://www.alldatasheet.com/datasheet-pdf/download/739974/HB/TEC1-12703.html)
 | Total | 90.80 €
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
