PFOC2203/Sistema-de-Controlo-de-Temperatura-utilizando-Celula-de-Peltier/Hardware/Placa PCB e Esquema.pdf

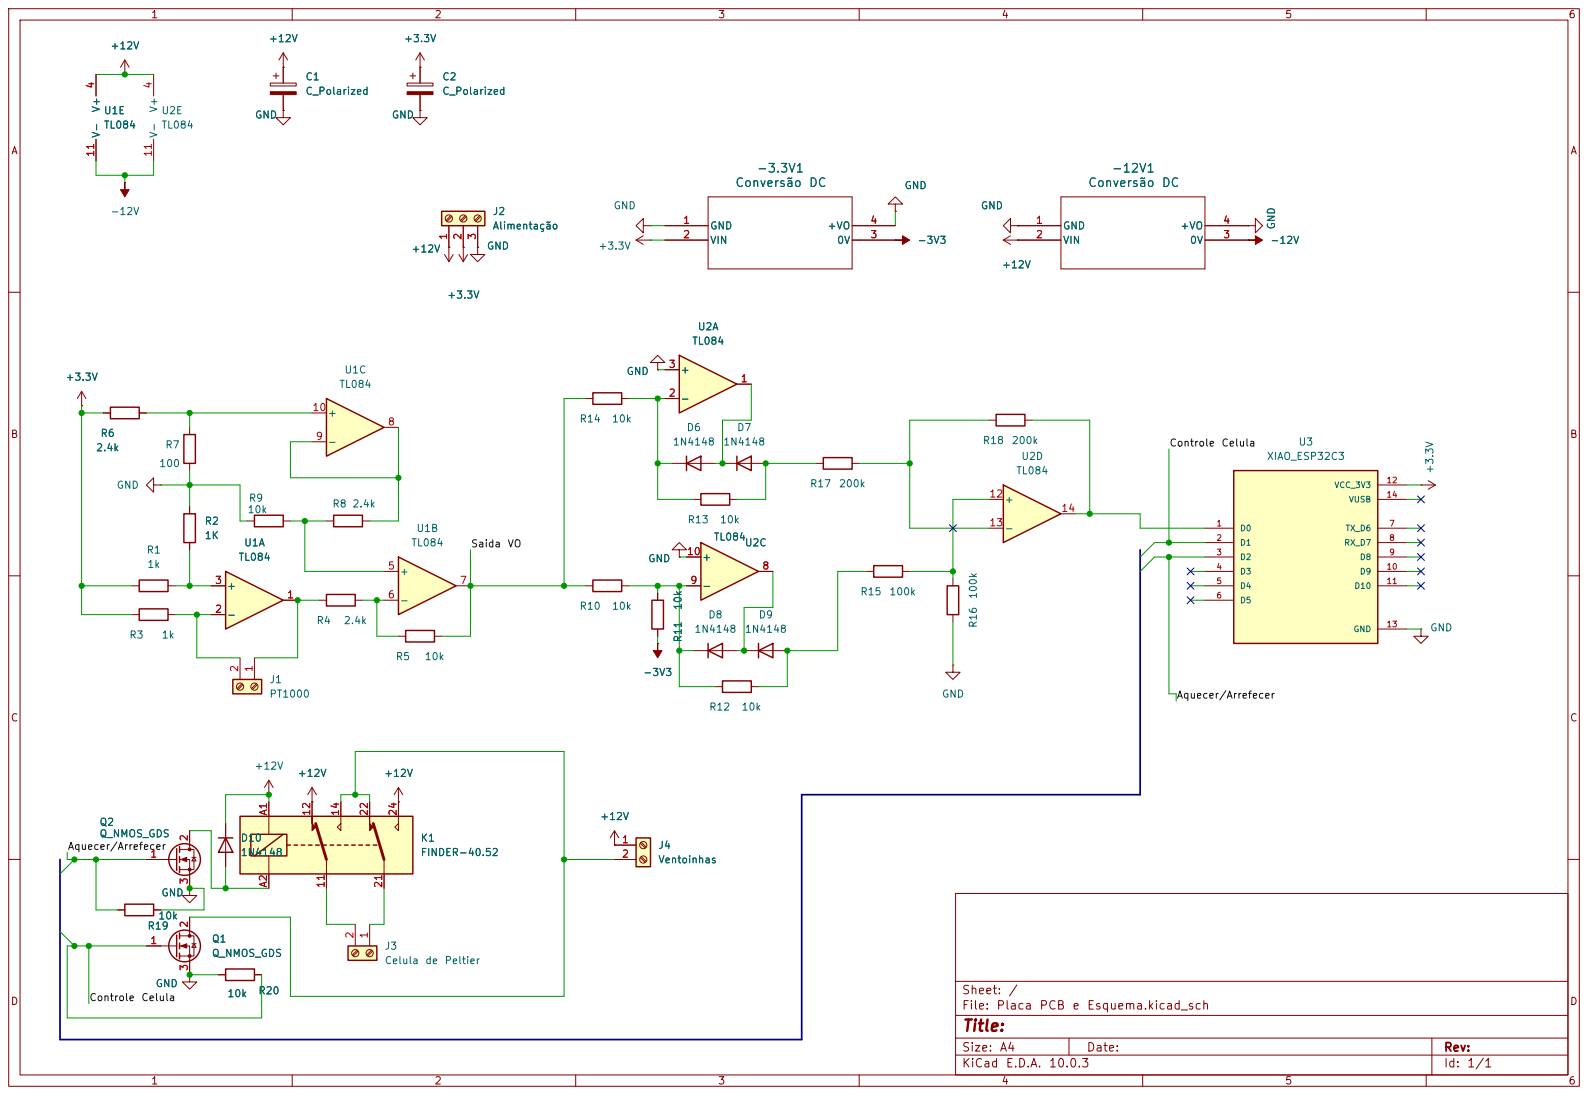
[picture p33: page 1]

GND +12V R6
Aquecer/Arrefecer Controle Celula Controle Celula
100 GND

Sheet: /
File: Placa PCB e Esquema.kicad_sch
Title:

Size: A4 | Rev:
KiCad E.D.A. 10.0.3 | Id: 1/1
