PFOC2203/Sistema-de-Controlo-de-Temperatura-utilizando-Celula-de-Peltier/Calculos/Simulação Pspice/P100_data_aquisiton-PSpiceFiles/SCHEMATIC1/DC Swep/DC Swep.cir

** Profile: "SCHEMATIC1-DC Swep"  [ C:\Users\VICTUS\OneDrive - Instituto Superior de Engenharia do Porto\licenciaturia em eltrotecnica e de computadores\3 ano\Pesta\Projeto\Calculos\Simulação Pspice\p100_data_aquisiton-pspicefiles\schematic1\dc swep.sim ] 

** Creating circuit file "DC Swep.cir" 
** WARNING: THIS AUTOMATICALLY GENERATED FILE MAY BE OVERWRITTEN BY SUBSEQUENT SIMULATIONS

*Libraries: 
* Profile Libraries :
* Local Libraries :
* From [PSPICE NETLIST] section of C:\cds_spb_home\cdssetup\OrCAD_PSpiceTIPSpice_Install\23.1.0\PSpice.ini file:
.lib "nom_pspti.lib" 
.lib "nom.lib" 

*Analysis directives: 
.DC LIN PARAM T -40 140 1 
.OPTIONS ADVCONV
.OPTIONS FILEMODELSEARCH
.PROBE64 V(alias(*)) I(alias(*)) W(alias(*)) D(alias(*)) NOISE(alias(*)) 
.INC "..\SCHEMATIC1.net" 


.END
