PFOC2203/Sistema-de-Controlo-de-Temperatura-utilizando-Celula-de-Peltier/(list of files, drawings)

Other design files:
Calculos/Simulação Pspice/P100_DATA_AQUISITON.DSN
Calculos/Simulação Pspice/P100_data_aquisiton.opj
