PFOC2203/Sistema-de-Controlo-de-Temperatura-utilizando-Celula-de-Peltier/Hardware/Placa PCB e Esquema/Placa PCB e Esquema.kicad_pcb

## KiCad design Hardware/Placa PCB e Esquema/Placa PCB e Esquema.kicad_pcb (2026-06-28)

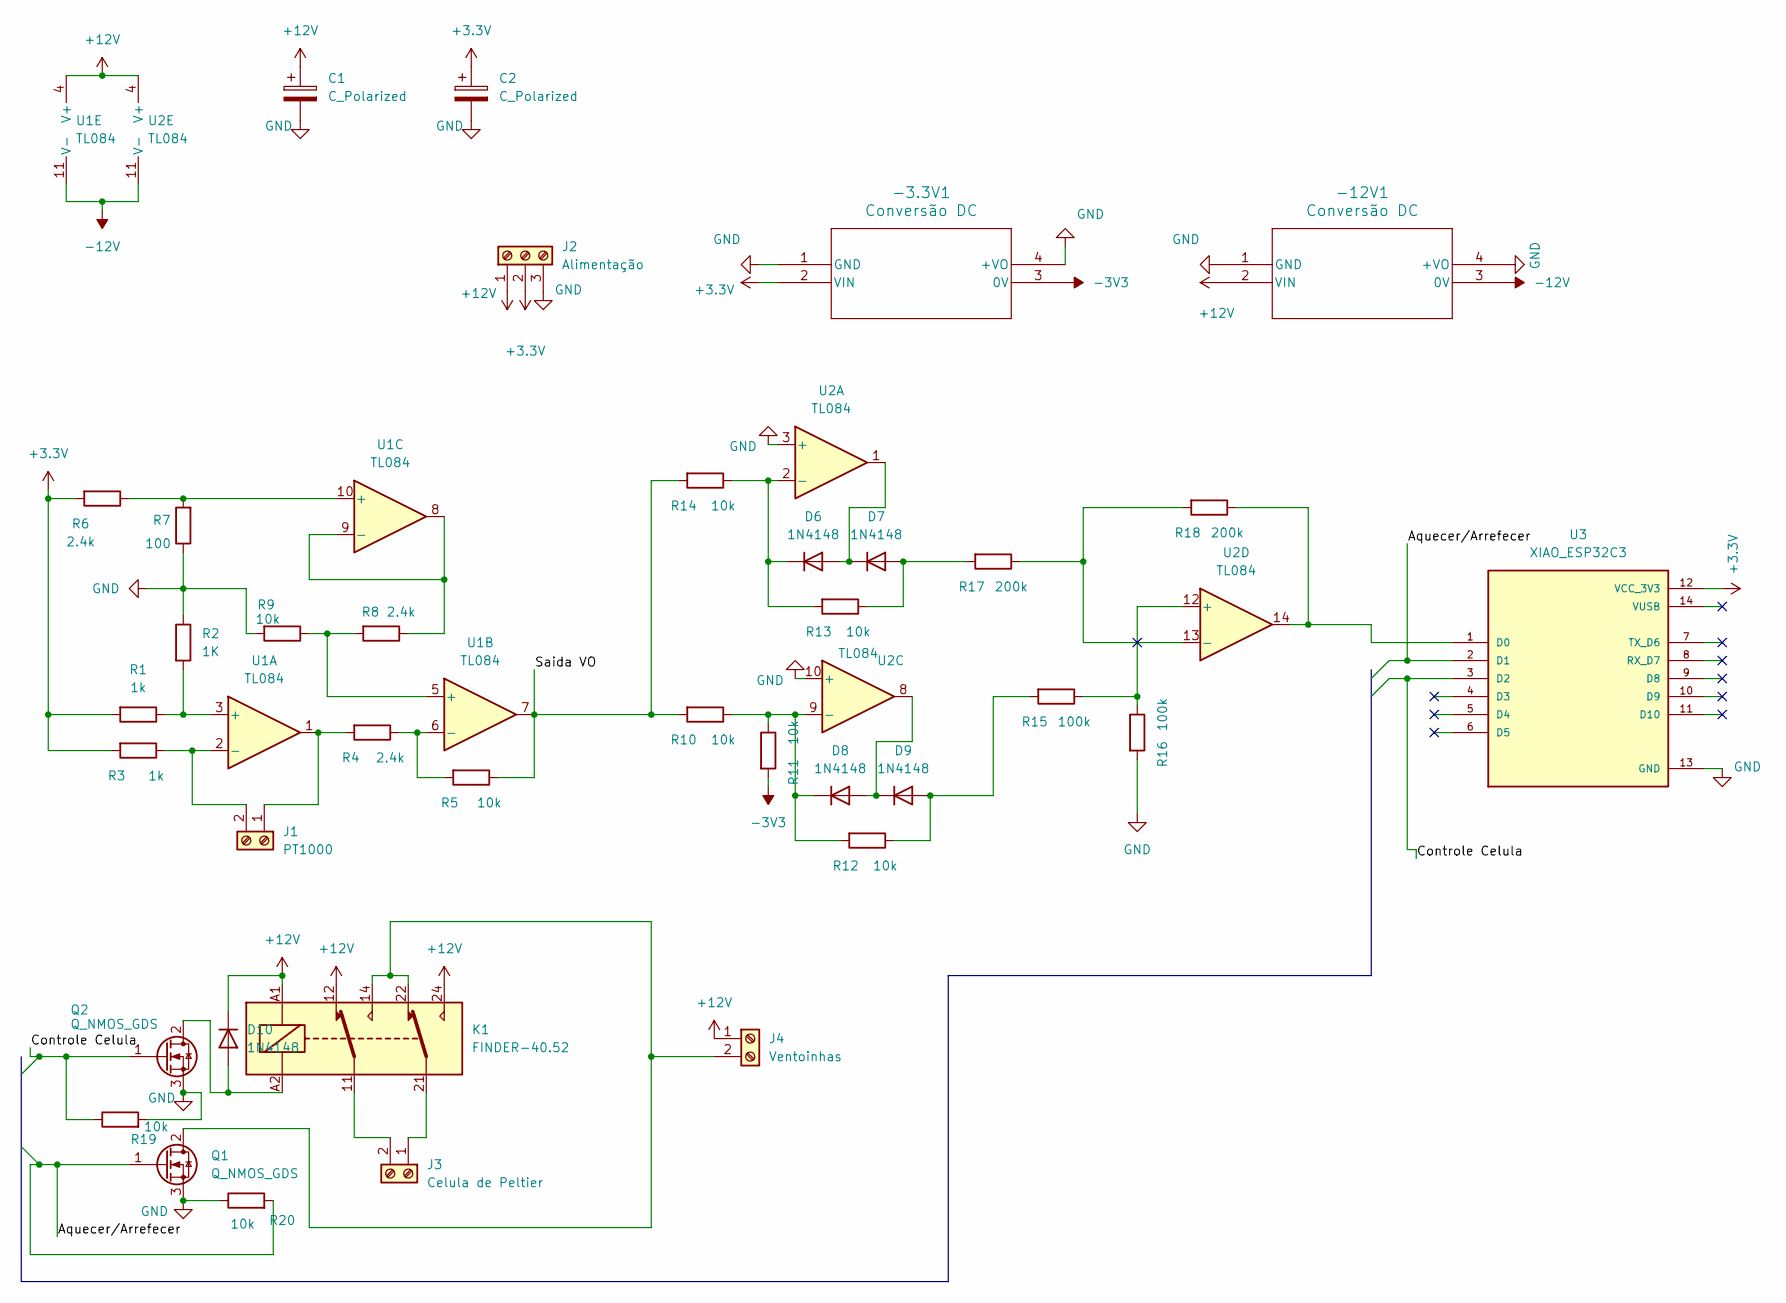
[picture p34: schematic Placa PCB e Esquema.kicad_sch]

Parts:
-3.3V1, -12V1: Conversão DC; Converter_DCDC_RECOM_R-78S-0.1_THT
C1, C2: C_Polarized; CP_Radial_Tantal_D5.5mm_P5.00mm
D6, D7, D8, D9, D10: 1N4148; D_DO-35_SOD27_P3.81mm_Vertical_CathodeUp
J1: PT1000; TerminalBlock_Phoenix_PT-1,5-2-5.0-H_1x02_P5.00mm_Horizontal
J2: Alimentação; TerminalBlock_Phoenix_MKDS-1,5-3_1x03_P5.00mm_Horizontal
J3: Celula de Peltier; TerminalBlock_Phoenix_MKDS-3-2-5.08_1x02_P5.08mm_Horizontal
J4: Ventoinhas; TerminalBlock_Phoenix_MKDS-3-2-5.08_1x02_P5.08mm_Horizontal
K1: FINDER-40.52; Relay_DPDT_Finder_40.52
Q1, Q2: Q_NMOS_GDS; TO-220-3_Horizontal_TabDown
R1, R3: 1k; R_Axial_DIN0204_L3.6mm_D1.6mm_P7.62mm_Horizontal
R2: 1K; R_Axial_DIN0204_L3.6mm_D1.6mm_P7.62mm_Horizontal
R4, R6, R8: 2.4k; R_Axial_DIN0204_L3.6mm_D1.6mm_P7.62mm_Horizontal
R5, R9, R10, R11, R12, R13, R14, R19, R20: 10k; R_Axial_DIN0204_L3.6mm_D1.6mm_P7.62mm_Horizontal
R7: 100; R_Axial_DIN0204_L3.6mm_D1.6mm_P7.62mm_Horizontal
R15, R16: 100k; R_Axial_DIN0204_L3.6mm_D1.6mm_P7.62mm_Horizontal
R17, R18: 200k; R_Axial_DIN0204_L3.6mm_D1.6mm_P7.62mm_Horizontal
U1, U2: TL084; DIP-14_W7.62mm
U3: XIAO_ESP32C3; MODULE_XIAO_ESP32C3; PARTREV 23/05/2022

Connections:
+3.3V: -3.3V1.2 (VIN), C2.1, J2.2, R1.2, R3.2, R6.2, U3.12 (VCC_3V3)
+12V: -12V1.2 (VIN), C1.1, D10.1 (K), J2.1, J4.1, K1.12, K1.24, K1.A1, U1.4 (V+), U2.4 (V+)
-3V3: -3.3V1.3 (0V), R11.2
-12V: -12V1.3 (0V), U1.11 (V-), U2.11 (V-)
/Aquecer/Arrefecer: Q1.1 (G), R20.2, U3.2 (D1)
/Controle Celula: Q2.1 (G), R19.1, U3.3 (D2)
/Saida VO: R5.1, R10.2, R14.2, U1.7
GND: -3.3V1.1 (GND), -3.3V1.4 (+VO), -12V1.1 (GND), -12V1.4 (+VO), C1.2, C2.2, J2.3, Q1.3 (S), Q2.3 (S), R2.1, R7.1, R9.2, R16.2, R19.2, R20.1, U2.3 (+), U2.10 (+), U3.13 (GND)
unnamed: D6.2 (A), D7.1 (K), U2.1
unnamed: D6.1 (K), R13.2, R14.1, U2.2 (-)
unnamed: D7.2 (A), R13.1, R17.2
unnamed: D8.2 (A), D9.1 (K), U2.8
unnamed: D8.1 (K), R10.1, R11.1, R12.2, U2.9 (-)
unnamed: D9.2 (A), R12.1, R15.2
unnamed: D10.2 (A), K1.A2, Q2.2 (D)
unnamed: J1.1, R4.2, U1.1
unnamed: J1.2, R3.1, U1.2 (-)
unnamed: J3.1, K1.21
unnamed: J3.2, K1.11
unnamed: J4.2, K1.14, K1.22, Q1.2 (D)
unnamed: R1.1, R2.2, U1.3 (+)
unnamed: R8.2, R9.1, U1.5 (+)
unnamed: R4.1, R5.2, U1.6 (-)
unnamed: R6.1, R7.2, U1.10 (+)
unnamed: R8.1, U1.8, U1.9 (-)
unnamed: R15.1, R16.1, U2.12 (+)
unnamed: R17.1, R18.2, U2.13 (-)
unnamed: R18.1, U2.14, U3.1 (D0)

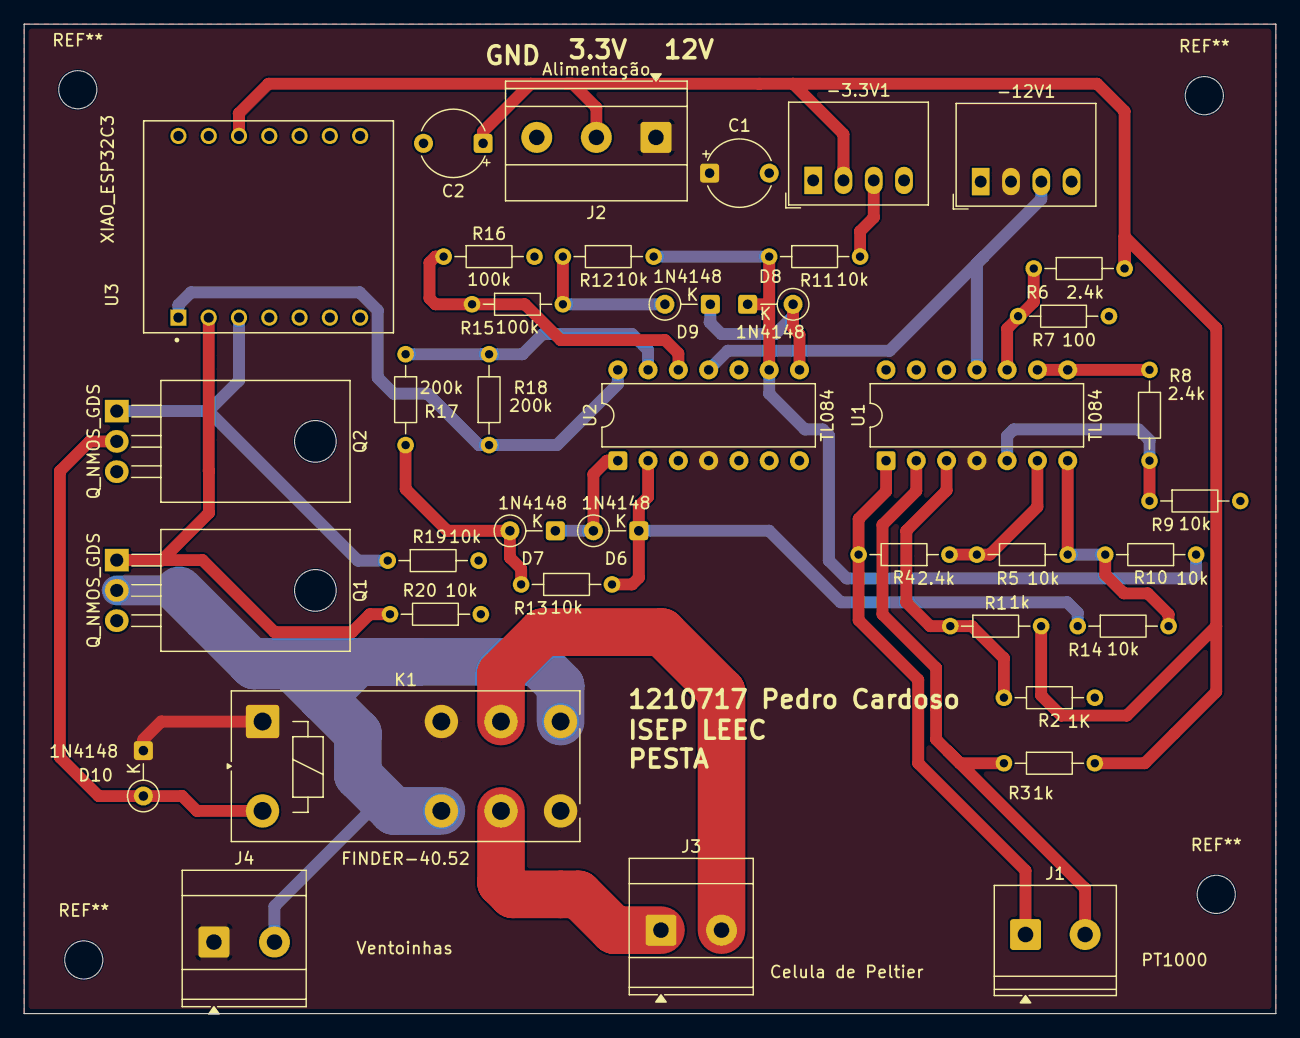
[picture p35: board Placa PCB e Esquema.kicad_pcb from above]

Board: 2 copper layers, 105.0 x 83.0 mm, 39 parts (0 on the bottom side), 28 nets.
