PFOC2203/Sistema-de-Controlo-de-Temperatura-utilizando-Celula-de-Peltier/(commit log)

2026-06-28 Primeiro commit: Adiciona hardware KiCad e software do termóstato
    [P100_DATA_AQUISITON.DSN, P100_data_aquisiton.opj, Placa PCB e Esquema.kicad_pcb, Placa PCB e Esquema.kicad_sch, Projeto LOGBOOK.xlsx]
2026-07-07 Prototipo Funcional V3
    [P100_DATA_AQUISITON.DSN, P100_data_aquisiton.opj, Placa PCB e Esquema.kicad_sch]
2026-07-08 Prototipo Funcional V4
    [Placa PCB e Esquema.kicad_sch]
2026-07-10 Codigo Final e Relatorio a precisar de ser revisto
    [Teste2.csv, Teste3.csv]
